MKVario/sweef/hardware/platine_v5/sweef_v5_bauteile_beschriftet.jpg

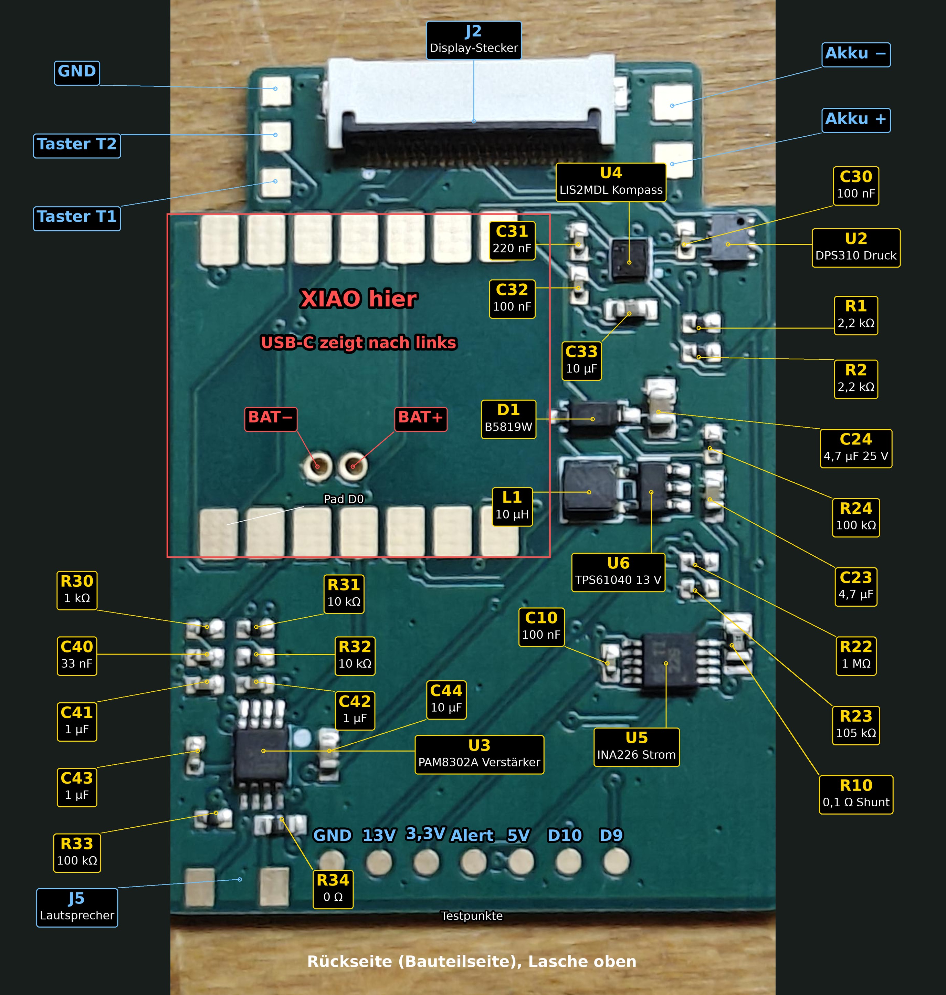
hardware/platine_v5/sweef_v5_bauteile_beschriftet.jpg
