MKVario/sweef/hardware/platine_v5/sweef_v5_vorderseite_beschriftet.jpg

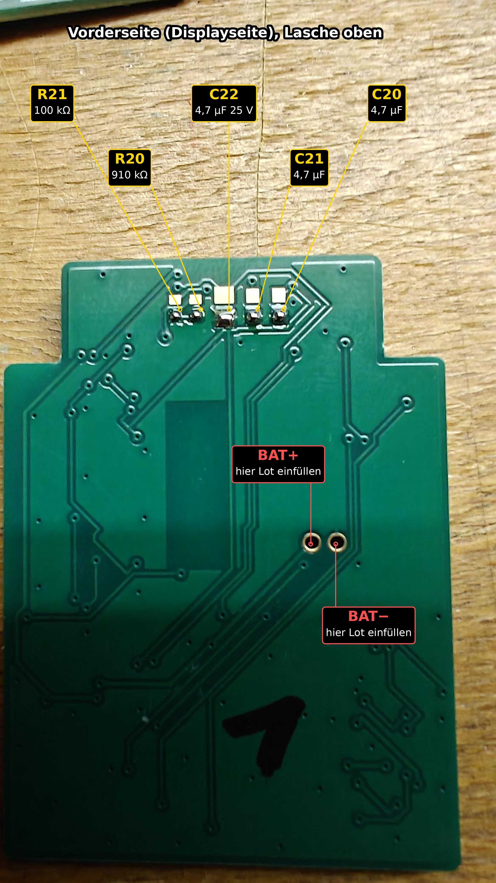
hardware/platine_v5/sweef_v5_vorderseite_beschriftet.jpg
