MKVario/sweef/docs/diagramme/sweef_akkutabelle_vergleich.png

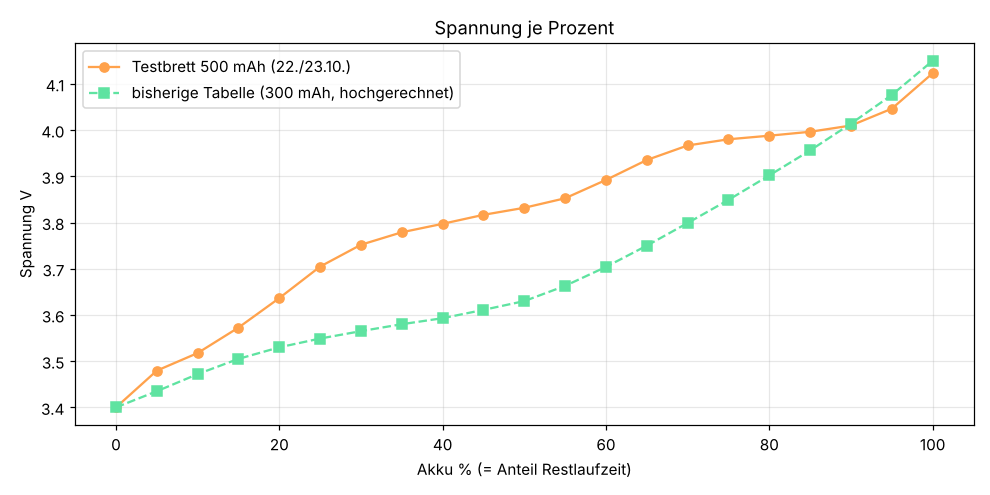
docs/diagramme/sweef_akkutabelle_vergleich.png
