MKVario/sweef/docs/diagramme/sweef_belastungstest.png

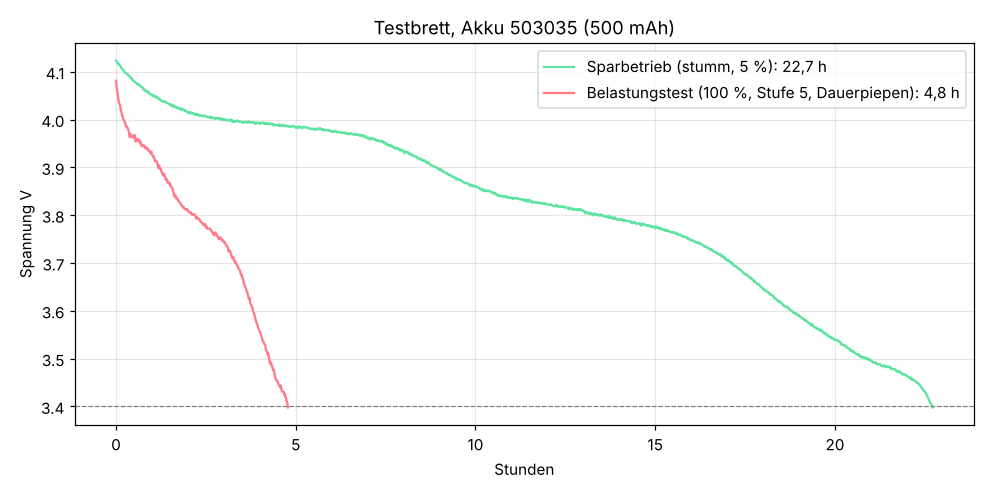
docs/diagramme/sweef_belastungstest.png
