MKVario/sweef/docs/diagramme/sweef_kompass_entwurf.png

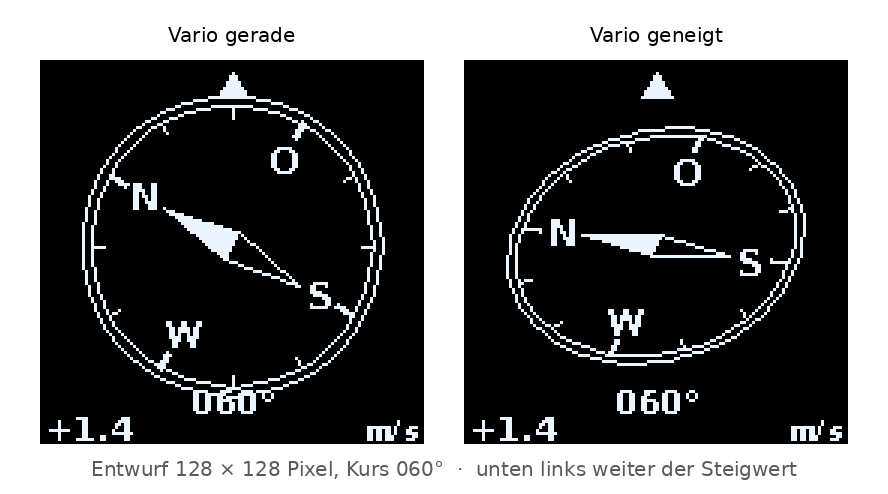
docs/diagramme/sweef_kompass_entwurf.png
