MKVario/sweef/docs/diagramme/sweef_ladekurve_2026-10-22.png

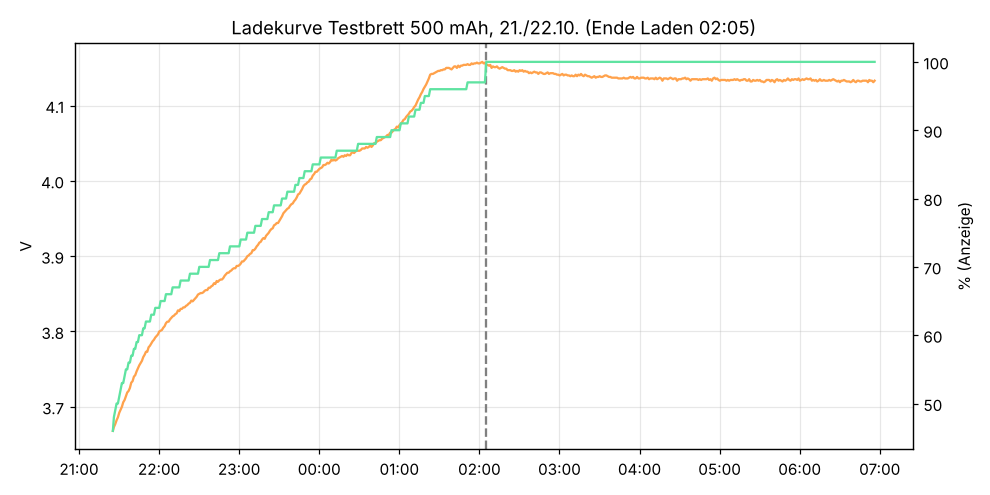
docs/diagramme/sweef_ladekurve_2026-10-22.png
