MKVario/sweef/docs/diagramme/sweef_platine_umriss_v1.png

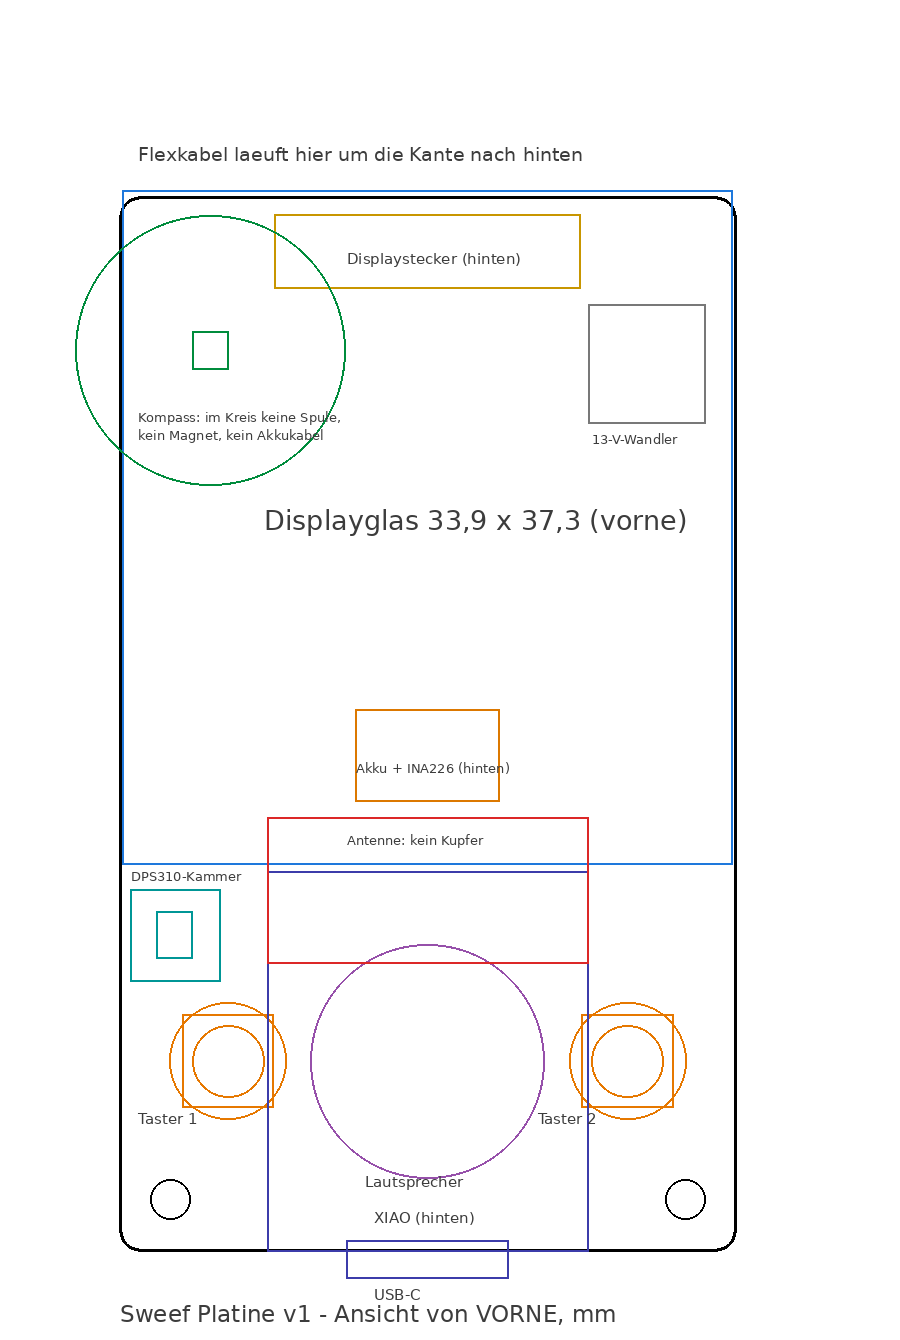
docs/diagramme/sweef_platine_umriss_v1.png
