MKVario/sweef/docs/diagramme/sweef_proportionen.png

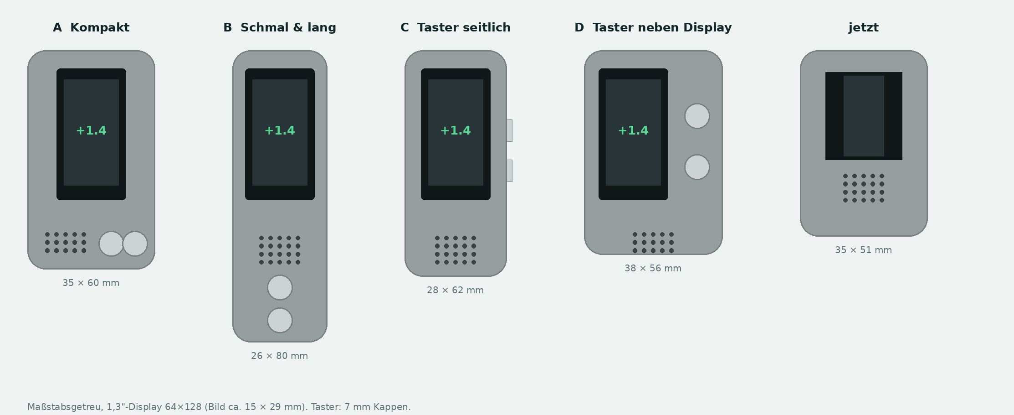
docs/diagramme/sweef_proportionen.png
