MKVario/sweef/docs/diagramme/sweef_rund_skizze.png

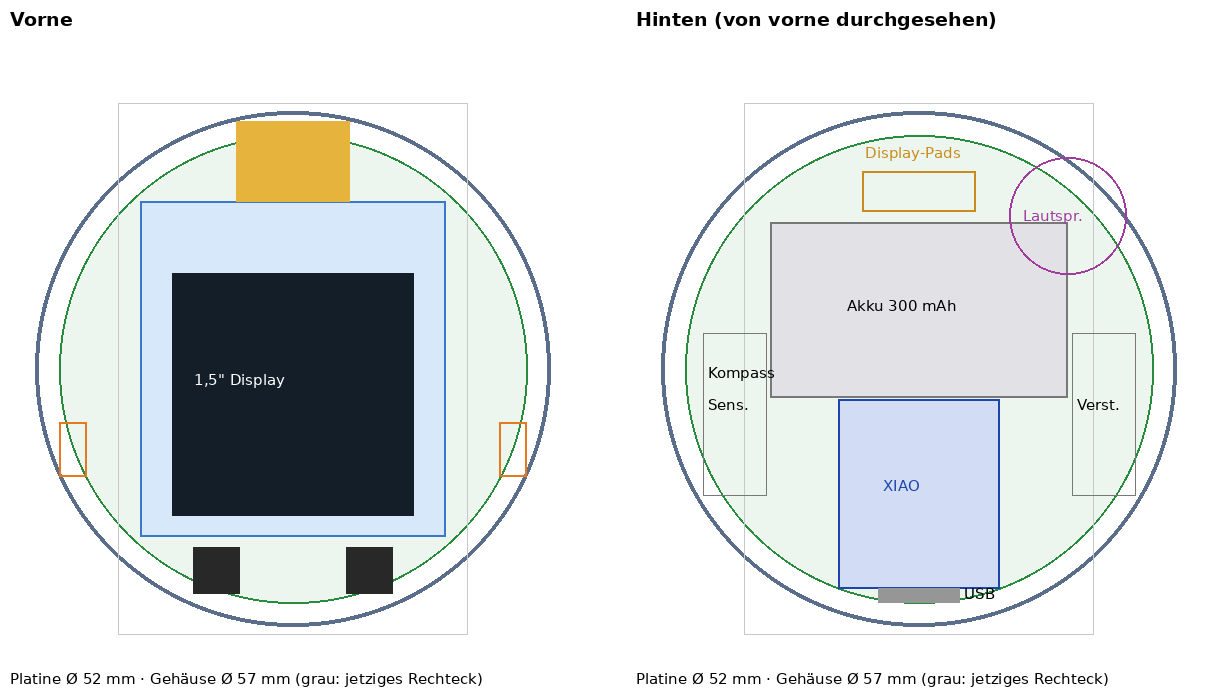
docs/diagramme/sweef_rund_skizze.png
