MKVario/sweef/docs/diagramme/sweef_skizze_platine.png

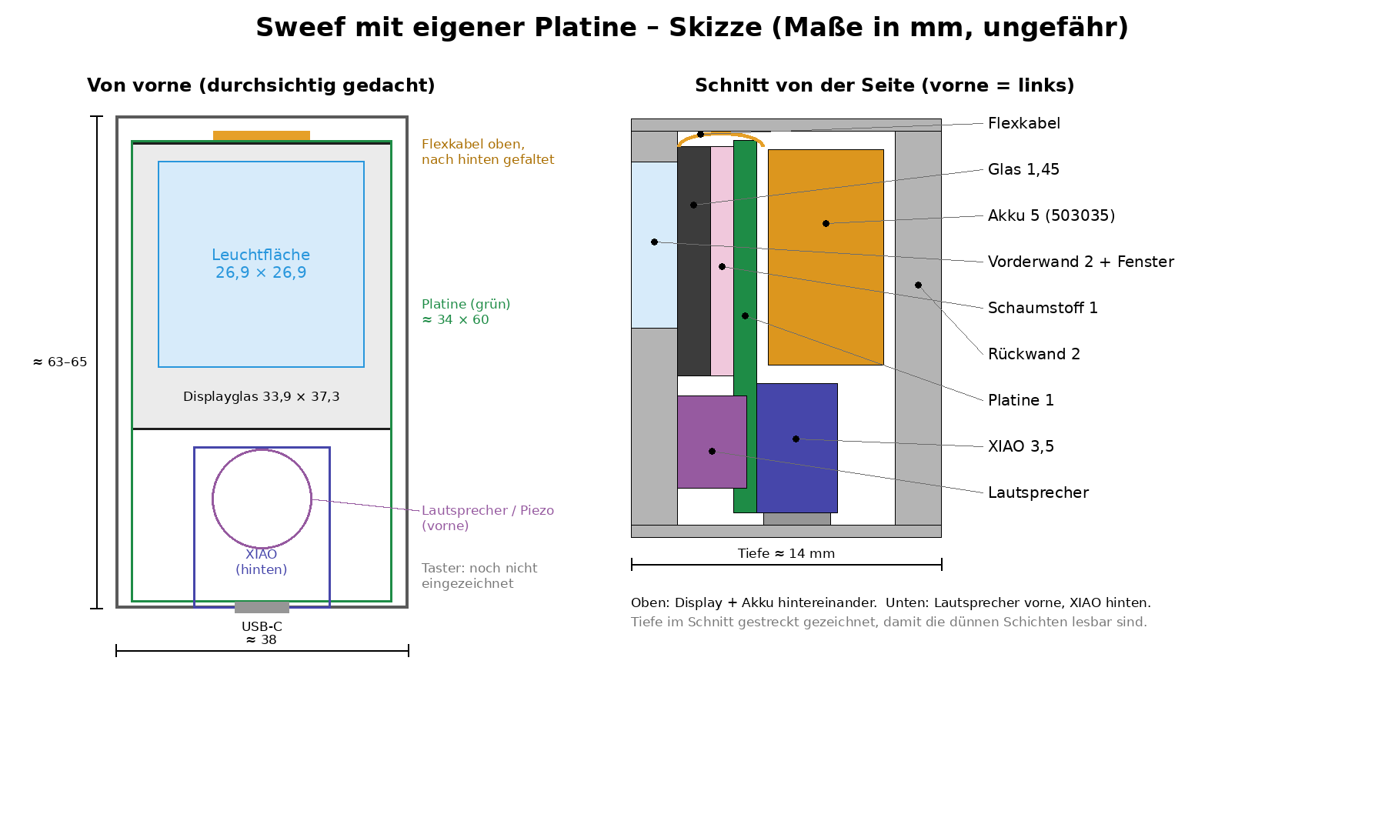
docs/diagramme/sweef_skizze_platine.png
