MKVario/sweef/docs/diagramme/sweef_taster_schnitt.png

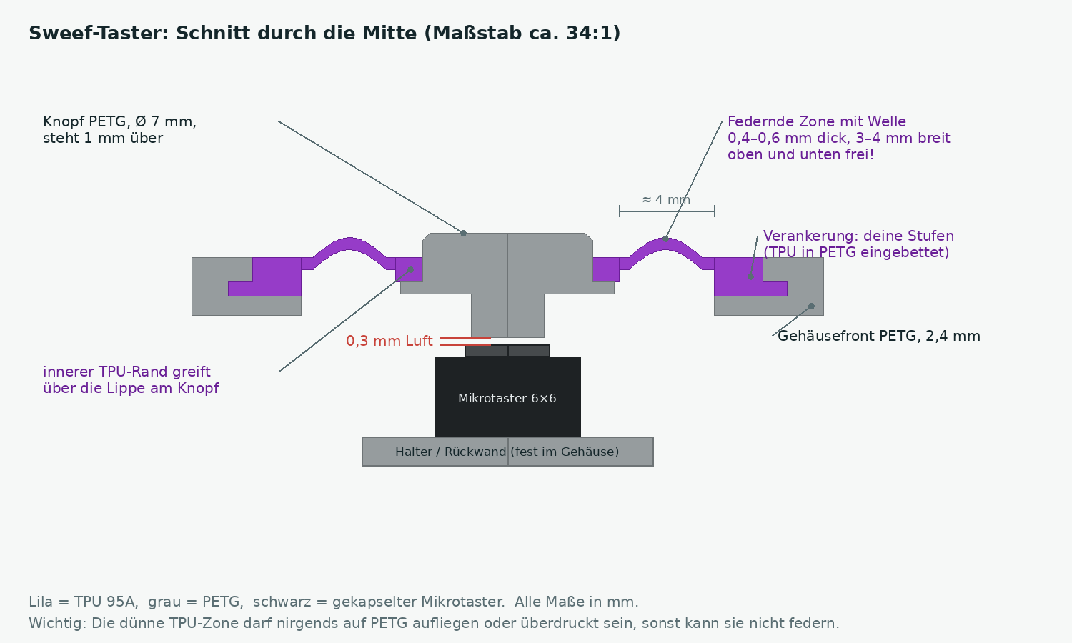
docs/diagramme/sweef_taster_schnitt.png
