MKVario/sweef/docs/diagramme/sweef_taster_stoessel.png

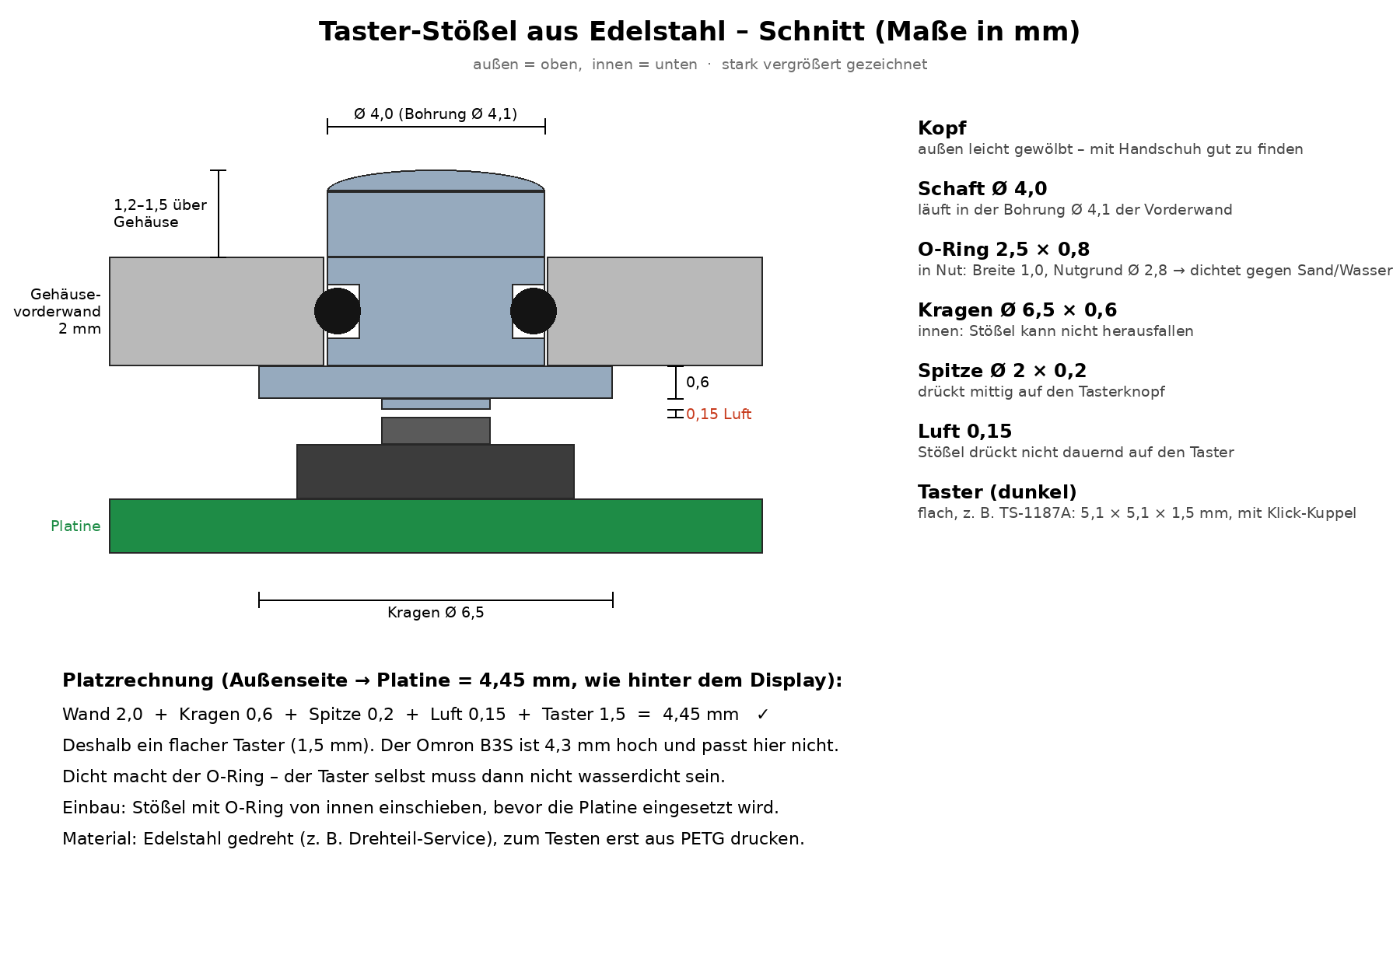
docs/diagramme/sweef_taster_stoessel.png
