MKVario/sweef/docs/diagramme/sweef_tropfen_skizze.png

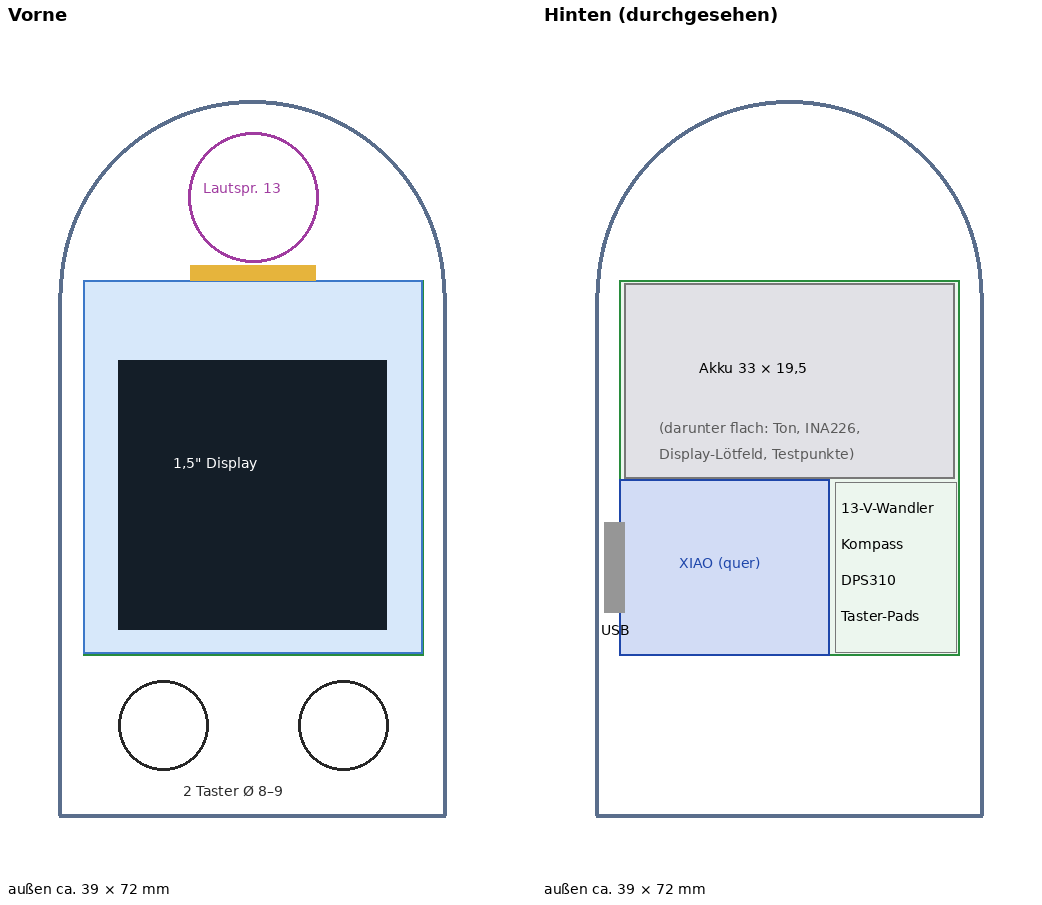
docs/diagramme/sweef_tropfen_skizze.png
