MKVario/sweef/docs/diagramme/sweef_verdrahtung.png

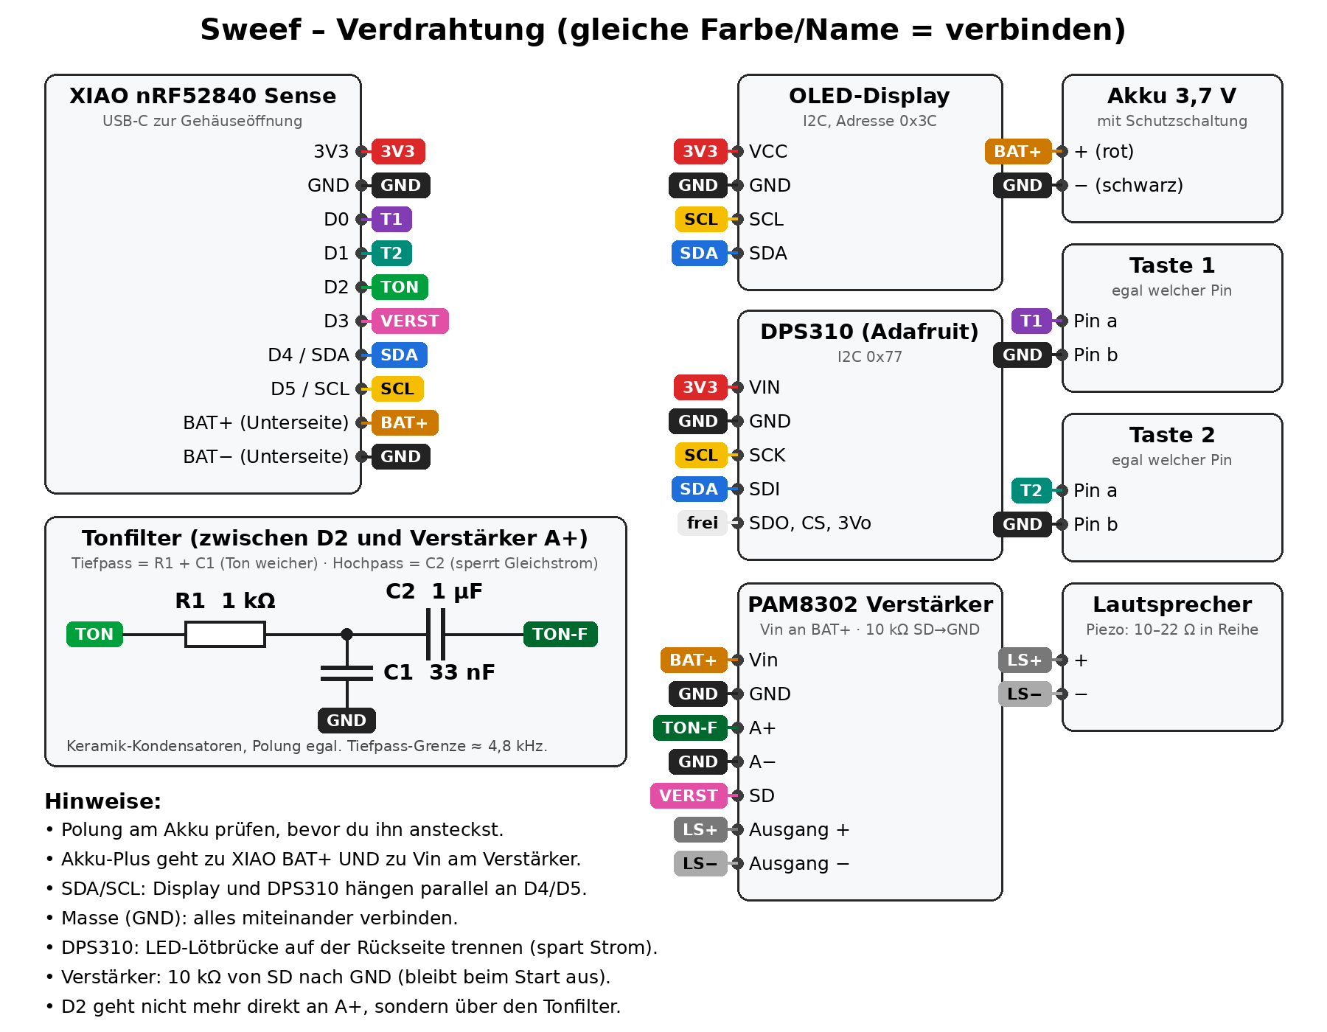
docs/diagramme/sweef_verdrahtung.png
