MKVario/sweef/hardware/gehaeuse/sweef_gehaeuse_v1_vorschau.png

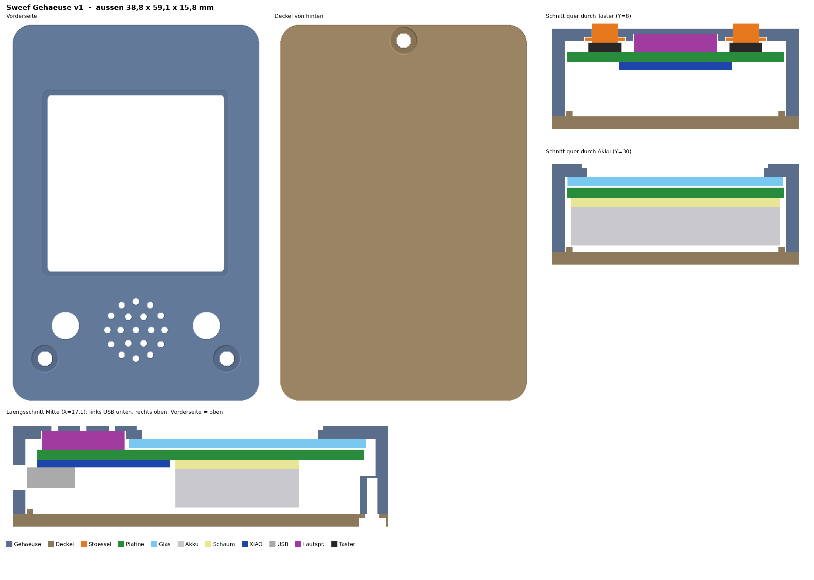
hardware/gehaeuse/sweef_gehaeuse_v1_vorschau.png
