MKVario/sweef/hardware/platine_v5/sweef_platine_umriss_v5.png

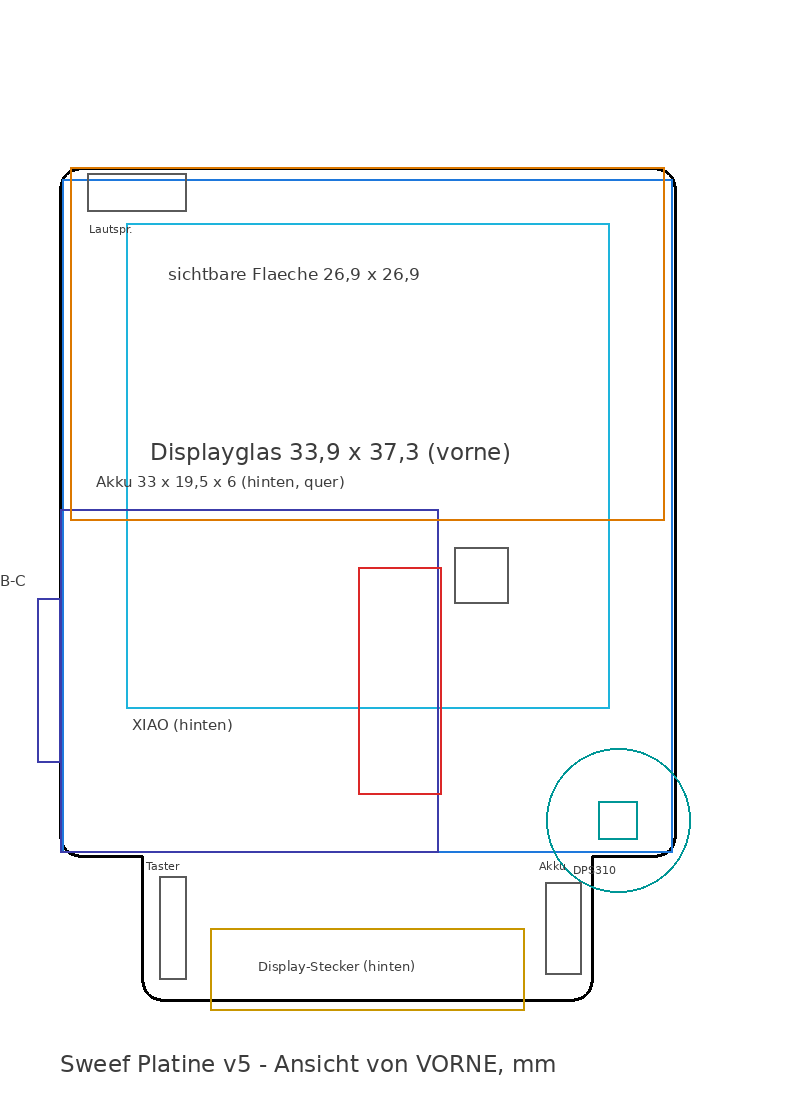
hardware/platine_v5/sweef_platine_umriss_v5.png
