MKVario/sweef/hardware/platine_v5/sweef_platine_v5_vorschau.png

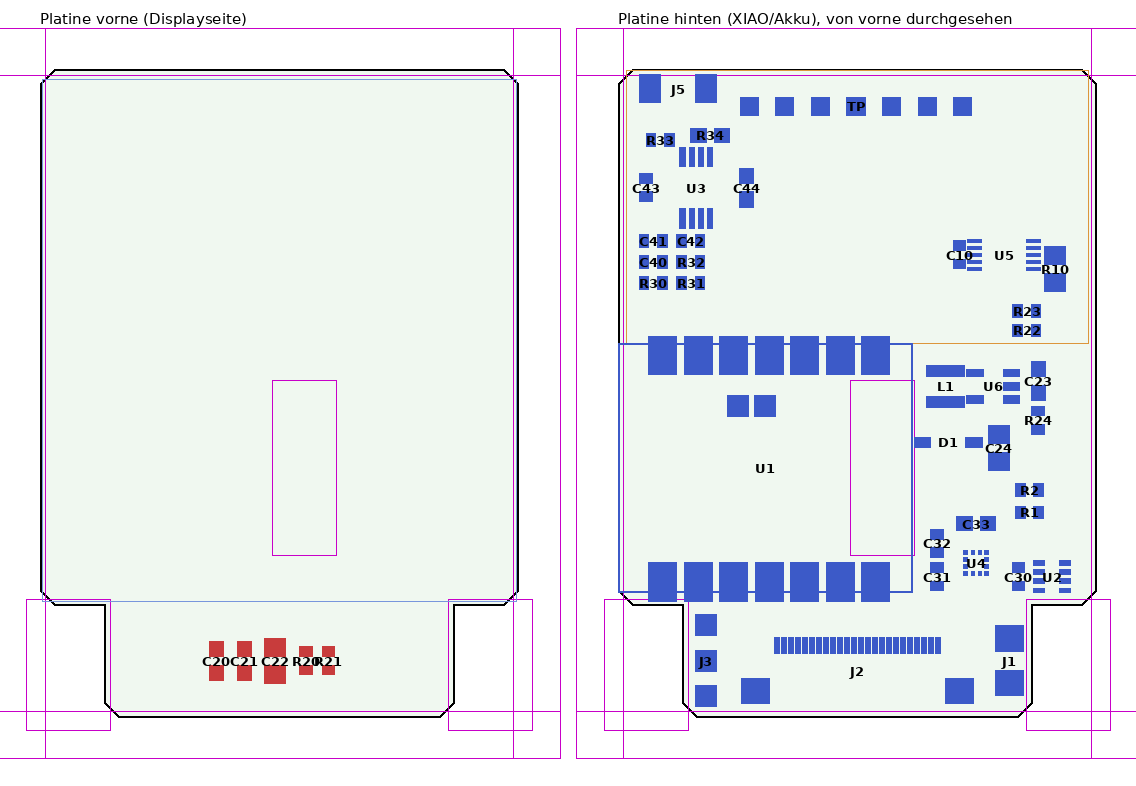
hardware/platine_v5/sweef_platine_v5_vorschau.png
