MKVario/sweef/hardware/Vario_Stueckliste.xlsx

Sheet: Stückliste
Stückliste Gleitschirm-Vario (Küstensoaring)
Gelbe Zellen selbst ausfüllen (Einzelpreis in €, Bestellnummer, Händler). Links sind Suchlinks, keine geprüften Produktseiten.
Pos. | Bauteil | Typ / Wert | Menge | Pflicht? | Bei Amazon suchen | Alternative Quelle | Einzelpreis (€) | Summe (€) | Händler / Bestellnr. | Anmerkung | Vorhanden daheim?
U1 | Controller | Seeed XIAO nRF52840 Sense (Standardversion, nicht Plus) | 1 | Ja | Amazon-Suche (https://www.amazon.de/s?k=Seeed+Studio+XIAO+nRF52840+Sense) | Berrybase (https://www.berrybase.de/search?sSearch=XIAO+nRF52840+Sense) |  |  |  | Sehr sparsamer Tiefschlaf, Bewegungssensor (LSM6DS3TR-C) ist eingebaut. Stiftleisten oder Randpads nutzbar.
U2 | Drucksensor | DPS310-Breakout (I²C) | 1 | Ja | Amazon-Suche (https://www.amazon.de/s?k=DPS310+Drucksensor+Modul+I2C) | Adafruit (https://www.adafruit.com/search?q=DPS310) |  |  |  | Vor Kauf prüfen: SDO und CSB herausgeführt bzw. auf I²C eingestellt, Pull-ups auf dem Board? | Gewählt: Adafruit-DPS310-Board (Berrybase) mit STEMMA-QT-Buchse. Kondensatoren, Regler und 10-kΩ-Pull-ups sind auf dem Board. Anschluss direkt an die Lötpads (VIN, GND, SCK, SDI), kein Kabel nötig.
DISP1 | OLED-Display | 0,91 Zoll, 128x32, SSD1306, I²C | 1 | Ja | Amazon-Suche (https://www.amazon.de/s?k=0%2C91+Zoll+OLED+Display+128x32+I2C+SSD1306) | Berrybase (https://www.berrybase.de/search?sSearch=OLED+0.91+SSD1306) |  |  |  | Adresse 0x3C. 4-Pin-Version mit VCC, GND, SCL, SDA. | Noch offen: 0,91 Zoll (128x32) oder 0,96 Zoll (128x64, quadratische Platine). Foto-Board hat 4,7-kΩ-Pull-ups, Kondensatoren, Regler.
U4 | Audio-Verstärker | PAM8302-Breakout (mono, Klasse D) | 1 | Ja | Amazon-Suche (https://www.amazon.de/s?k=PAM8302+Verstärker+Modul+2.5W+mono) | Adafruit (https://www.adafruit.com/search?q=PAM8302) |  |  |  | Pins prüfen: VIN, GND, A+, A-, SD (Shutdown), OUT+, OUT-. Versorgung aus dem Akku (ca. 2-5,5 V). | Gewähltes Board PAM8302A: Poti 'Vol', Schraubklemme für den Lautsprecher, Kondensatoren sind drauf.
LS1 | Lautsprecher | LSF-13SMD2 (Wunsch) oder abgedichtet LSF-S1318A-IPX7 (empfohlen wegen Sand), 8 Ω, ca. 0,7 W | 1 | Ja | Amazon-Suche (https://www.amazon.de/s?k=Lautsprecher+8+Ohm+0.7W+SMD+13mm) | Reichelt (https://www.reichelt.de/index.html?SEARCH=LSF-S1318A-IPX7) |  |  |  | Datenblatt prüfen: Impedanz, Leistung, Resonanz (ca. 850-1100 Hz). Nur an OUT+ und OUT-, nie an GND.
BT1 | Akku | LiPo 3,7 V, 500 mAh, mit Schutzschaltung | 1 | Ja | Amazon-Suche (https://www.amazon.de/s?k=LiPo+Akku+3.7V+500mAh+JST+PH+2.0+Schutzschaltung) | Berrybase (https://www.berrybase.de/search?sSearch=LiPo+500mAh) |  |  |  | Wegen des Lautsprechers 500 mAh. Typische Bauform 503035 (ca. 5 x 30 x 35 mm), Platz im Gehäuse prüfen. Polung des Steckers vor dem Anschließen prüfen (oft vertauscht).
J1 | Akkustecker | JST-PH 2-polig, Buchse für die Platine (THT) | 1 | Ja | Amazon-Suche (https://www.amazon.de/s?k=JST+PH+2.0+Buchse+2+polig+THT+Stiftleiste) | Reichelt (https://www.reichelt.de/index.html?SEARCH=JST+PH+2-polig+Stiftleiste) |  |  |  | Muss zum Stecker des Akkus passen (PH, 2,0 mm Raster).
SW1, SW2 | Taster | gekapselt, IP67, 6x6 mm, Silikonmembran | 2 | Ja | Amazon-Suche (https://www.amazon.de/s?k=Wasserdichter+Taster+IP67+6x6+Mini) | Reichelt (https://www.reichelt.de/index.html?SEARCH=Taster+IP67) |  |  |  | Ein/Aus bzw. Lautstärke und Höhen-Reset. Schalten gegen GND, keine Widerstände nötig. | ENTFÄLLT: ersetzt durch die Edelstahl-Einbautaster (nächste Zeile).
SW1, SW2 (Einbau) | Taster (Einbau) | Edelstahl, 8 mm Einbaudurchmesser, wasserdicht, Schließer, selbstrückstellend, mit O-Ring und Mutter | 2 | Ja | Amazon-Suche (https://www.amazon.de/s?k=Larcele+8mm+Mini+Metall+Drucktaster+wasserdicht+momentan+Edelstahl) | Reichelt (https://www.reichelt.de/index.html?SEARCH=Einbau+Drucktaster+8mm+Edelstahl+IP67) |  |  |  | Auf die linke Gehäuseseite, Mittenabstand mindestens 18-20 mm. Einfache Variante mit 2 Anschlüssen, ohne LED. In der Anzeige IP-Angabe, Gewindelänge und Kopfhöhe prüfen. Das Amazon-Set enthält 5 Stück (ca. 34,49 € laut Anzeige). Kabel an D0, D1 und GND.
C10, C11 | Kondensatoren | 100 nF, Keramik (bedrahtet oder 0805), am XIAO-Pin zwischen Signal und GND | 2 | Optional | Amazon-Suche (https://www.amazon.de/s?k=Kondensator+Keramik+100nF+bedrahtet+Sortiment) | Reichelt (https://www.reichelt.de/index.html?SEARCH=Keramikkondensator+100nF) |  |  |  | Optional: glättet Störungen auf den Tasterkabeln, schützt etwas vor statischer Entladung. | Ja
C1 | Kondensator | 10 µF, 0805 (Controller) | 1 | Ja | Amazon-Suche (https://www.amazon.de/s?k=0805+SMD+Kondensator+Sortiment+100nF+10uF+1uF) | Reichelt (https://www.reichelt.de/index.html?SEARCH=SMD+0805+10uF) |  |  |  | Amazon liefert meist Sortimente mit vielen Werten.
C2 | Kondensator | 100 nF, 0805 (Controller) | 1 | Ja | Amazon-Suche (https://www.amazon.de/s?k=0805+SMD+Kondensator+Sortiment+100nF+10uF+1uF) | Reichelt (https://www.reichelt.de/index.html?SEARCH=SMD+0805+100nF)
C3 | Kondensator | 10 µF, 0805 (Verstärker) | 1 | Ja | Amazon-Suche (https://www.amazon.de/s?k=0805+SMD+Kondensator+Sortiment+100nF+10uF+1uF) | Reichelt (https://www.reichelt.de/index.html?SEARCH=SMD+0805+10uF) |  |  |  | Direkt am Verstärker platzieren. | ENTFÄLLT beim gewählten PAM8302A-Board (Kondensatoren sind drauf).
C4 | Kondensator | 100 nF, 0805 (Verstärker) | 1 | Ja | Amazon-Suche (https://www.amazon.de/s?k=0805+SMD+Kondensator+Sortiment+100nF+10uF+1uF) | Reichelt (https://www.reichelt.de/index.html?SEARCH=SMD+0805+100nF) |  |  |  | Direkt am Verstärker platzieren. | ENTFÄLLT beim gewählten PAM8302A-Board (Kondensatoren sind drauf).
C5 | Kondensator | 1 µF, 0805 (Koppelkondensator am Verstärkereingang) | 1 | Ja | Amazon-Suche (https://www.amazon.de/s?k=0805+SMD+Kondensator+Sortiment+100nF+10uF+1uF) | Reichelt (https://www.reichelt.de/index.html?SEARCH=SMD+0805+1uF) |  |  |  | Entfällt, wenn das PAM8302-Board schon einen Eingangskondensator hat. | ENTFÄLLT beim gewählten PAM8302A-Board (Eingangskondensatoren sind drauf).
C6-C8 | Kondensatoren | 100 nF, 0805 (Sensoren) | 3 | Optional | Amazon-Suche (https://www.amazon.de/s?k=0805+SMD+Kondensator+Sortiment+100nF+10uF+1uF) | Reichelt (https://www.reichelt.de/index.html?SEARCH=SMD+0805+100nF) |  |  |  | Nur, wenn die Breakouts keine eigenen Kondensatoren haben. | ENTFÄLLT bei den gewählten Boards (DPS310-Board und OLED-Board haben eigene Kondensatoren).
C9 | Kondensator | Tiefpass für Tonsignal, Startwert ca. 22 nF, 0805 | 1 | Ja | Amazon-Suche (https://www.amazon.de/s?k=0805+SMD+Kondensator+Sortiment+100nF+10uF+1uF) | Reichelt (https://www.reichelt.de/index.html?SEARCH=SMD+0805+22nF) |  |  |  | Endgültiger Wert wird beim Test bestimmt.
R1, R2 | Widerstände | 4,7 kΩ, 0805 (I²C Pull-ups) | 2 | Optional | Amazon-Suche (https://www.amazon.de/s?k=0805+SMD+Widerstand+Sortiment+1%25+E12) | Reichelt (https://www.reichelt.de/index.html?SEARCH=SMD+0805+4%2C7k) |  |  |  | Entfallen, wenn die Breakouts Pull-ups haben. | ENTFALLEN bei den gewählten Boards (DPS310-Board und OLED-Board haben Pull-ups).
R3, R4 | Widerstände | Spannungsteiler am Verstärkereingang, Werte im Test (z. B. 1 kΩ bis 47 kΩ), 0805 | 2 | Ja | Amazon-Suche (https://www.amazon.de/s?k=0805+SMD+Widerstand+Sortiment+1%25+E12) | Reichelt (https://www.reichelt.de/index.html?SEARCH=SMD+0805+10k) |  |  |  | Begrenzt die Höchstlautstärke auf einen für den Lautsprecher sicheren Wert. | ENTFALLEN beim gewählten PAM8302A-Board (das Poti 'Vol' übernimmt die Begrenzung).
R5 | Widerstand | Tiefpass für Tonsignal, Startwert ca. 1 kΩ, 0805 | 1 | Ja | Amazon-Suche (https://www.amazon.de/s?k=0805+SMD+Widerstand+Sortiment+1%25+E12) | Reichelt (https://www.reichelt.de/index.html?SEARCH=SMD+0805+1k) |  |  |  | Endgültiger Wert wird beim Test bestimmt.
PCB | Platine | nach deinem Eagle-Layout | 1 | Ja | nicht bei Amazon | JLCPCB (https://jlcpcb.com/) |  |  |  | Bei Amazon nicht sinnvoll. Gerber-Dateien hochladen, z. B. bei JLCPCB oder PCBWay.
X1 | Stift-/Buchsenleisten | 2,54 mm, für die Module | 1 | Ja | Amazon-Suche (https://www.amazon.de/s?k=Stiftleiste+Buchsenleiste+2.54mm+Set) | Reichelt (https://www.reichelt.de/index.html?SEARCH=Stiftleiste+2%2C54) |  |  |  | Fest verlötet wird es flacher, Buchsen erlauben Modultausch.
X2 | Stiftleiste | 2-polig, 2,54 mm (Reset-Testpunkt) | 1 | Ja | Amazon-Suche (https://www.amazon.de/s?k=Stiftleiste+Buchsenleiste+2.54mm+Set) | Reichelt (https://www.reichelt.de/index.html?SEARCH=Stiftleiste+2%2C54) |  |  |  | Für den Notfall-Reset von Hand, wenn das Gerät hängt.
- | Schrauben, Abstandshalter | M2-Set, für Sensorboards und Gehäuse | 1 | Ja | Amazon-Suche (https://www.amazon.de/s?k=M2+Schrauben+Abstandshalter+Set+Nylon) | Reichelt (https://www.reichelt.de/index.html?SEARCH=Abstandsbolzen+M2) |  |  |  | Sensorboards starr befestigen.
- | Schutzlack | Conformal Coating, Dose/Spray | 1 | Ja | Amazon-Suche (https://www.amazon.de/s?k=Schutzlack+Platine+Conformal+Coating+Spray) | Reichelt (https://www.reichelt.de/index.html?SEARCH=Schutzlack+Platine) |  |  |  | Erst nach dem Test auftragen, Anschlüsse und Taster vorher abkleben.
- | Staubschutz USB-C | Silikonkappe | 1 | Ja | Amazon-Suche (https://www.amazon.de/s?k=Silikon+Staubschutz+USB-C+Stopfen) | - |  |  |  | Hält Sand aus dem Anschluss.
- | Gitter vor dem Lautsprecher | Edelstahlgewebe, fein | 1 | Ja | Amazon-Suche (https://www.amazon.de/s?k=Edelstahl+Gewebe+Mesh+fein+Filter) | - |  |  |  | Schutz vor Sand.
- | Membran vor dem Drucksensor | PTFE, wasserabweisend, belüftend | 1 | Ja | Amazon-Suche (https://www.amazon.de/s?k=PTFE+Membran+Belüftung+wasserdicht+Aufkleber+Vent) | - |  |  |  | Muss luftdurchlässig sein.
- | Schaumstoff | klein, dünn | 1 | Ja | Amazon-Suche (https://www.amazon.de/s?k=Schaumstoff+Platte+3mm+selbstklebend) | - |  |  |  | Winddämpfung am Drucksensor, Entkopplung des Lautsprechers.
- | Dichtung | Silikon-Dichtschnur oder Silikonband | 1 | Ja | Amazon-Suche (https://www.amazon.de/s?k=Silikon+Dichtschnur+2mm+rund) | - |  |  |  | Umlaufend am Gehäuse.
- | Gehäuse-Material | PETG-Filament, weiß oder hellgrau | 1 | Ja | Amazon-Suche (https://www.amazon.de/s?k=PETG+Filament+1.75mm+weiß) | - |  |  |  | Nur, wenn du selbst druckst. Hell wegen Sonne.
- | Befestigung am Tragegurt | Klettband oder Clip | 1 | Ja | Amazon-Suche (https://www.amazon.de/s?k=Klettband+Set+selbstklebend+breit) | - |  |  |  | Je nach Gurtbreite.
- | Litze | dünn, z. B. 0,14 mm² | 1 | Ja | Amazon-Suche (https://www.amazon.de/s?k=Silikonlitze+26AWG+Set) | -
- | Schrumpfschlauch | Sortiment | 1 | Ja | Amazon-Suche (https://www.amazon.de/s?k=Schrumpfschlauch+Set) | -
- | USB-C-Datenkabel | kurz, mit Datenleitungen | 1 | Ja | Amazon-Suche (https://www.amazon.de/s?k=USB-C+Datenkabel+kurz) | - |  |  |  | Kein reines Ladekabel, sonst kein Programmieren möglich.
T1 | Kondensatoren (bedrahtet) | 100 nF, Keramik, Raster 2,5 oder 5 mm (statt C2, C4, optional C6/C7) | 4 | Alternativ | Amazon-Suche (https://www.amazon.de/s?k=Kondensator+Keramik+100nF+bedrahtet+Sortiment) | Reichelt (https://www.reichelt.de/index.html?SEARCH=Keramikkondensator+100nF) |  |  |  | Für die gedruckte Trägerplatte: Ersatz für die 0805-SMD-Teile. Direkt an die Versorgungspins der Module löten. | Mit den gewählten Boards nur noch für C2 nötig (C4, C6, C7 entfallen). | Ja
T2 | Kondensatoren (bedrahtet) | 10 µF Elko, mind. 16 V (statt C1, C3) | 2 | Alternativ | Amazon-Suche (https://www.amazon.de/s?k=Elko+10uF+16V+bedrahtet+Sortiment) | Reichelt (https://www.reichelt.de/index.html?SEARCH=Elko+10uF+16V+radial) |  |  |  | Polung beachten (Minus-Streifen am Gehäuse). | Mit den gewählten Boards nur noch für C1 nötig (C3 entfällt). | Ja
T3 | Kondensator (bedrahtet) | 1 µF, Folie oder Keramik (statt C5) | 1 | Alternativ | Amazon-Suche (https://www.amazon.de/s?k=Kondensator+1uF+bedrahtet+Folie+Keramik) | Reichelt (https://www.reichelt.de/index.html?SEARCH=Kondensator+1uF+RM5) |  |  |  | Entfällt, wenn das PAM8302-Board einen Eingangskondensator hat. | ENTFÄLLT beim gewählten PAM8302A-Board. | Ja
T4 | Kondensator (bedrahtet) | ca. 22 nF, Folie oder Keramik (statt C9) | 1 | Alternativ | Amazon-Suche (https://www.amazon.de/s?k=Kondensator+22nF+bedrahtet+Folie) | Reichelt (https://www.reichelt.de/index.html?SEARCH=Kondensator+22nF+RM5) |  |  |  | Endgültiger Wert wird beim Test bestimmt. | Ja
T5 | Widerstände (bedrahtet) | 1/4 W, Sortiment E12 (statt R1-R5) | 5 | Alternativ | Amazon-Suche (https://www.amazon.de/s?k=Widerstand+Sortiment+1%2F4W+E12+bedrahtet) | Reichelt (https://www.reichelt.de/index.html?SEARCH=Widerstand+1%2F4W+Sortiment) |  |  |  | R5 Startwert 1 kΩ, R3/R4 im Test, R1/R2 (4,7 kΩ) nur falls die Boards keine Pull-ups haben. | Mit den gewählten Boards nur noch für R5 nötig (R1-R4 entfallen). | Ja
T6 | Lochrasterplatine | Stück ca. 20 x 15 mm, Raster 2,54 mm | 1 | Alternativ | Amazon-Suche (https://www.amazon.de/s?k=Lochrasterplatine+2.54mm+Set+klein) | Reichelt (https://www.reichelt.de/index.html?SEARCH=Lochrasterplatine+2%2C54) |  |  |  | Für die Audio-Filterkette (R5, C9, R3, R4, C5). Wird in die Trägerplatte eingesetzt.
T7 | Gewindeeinsätze und Schrauben | M2 Heat-Set-Einsätze, M2-Schrauben, Set | 1 | Alternativ | Amazon-Suche (https://www.amazon.de/s?k=M2+Gewindeeinsätze+Heat+Set+3D+Druck+Set+Schrauben) | Reichelt (https://www.reichelt.de/index.html?SEARCH=Gewindeeinsatz+M2) |  |  |  | Für die gedruckte Trägerplatte. Direkt in den Kunststoff gedrehte Gewinde lockern sich bei Vibration.
T8 | Kabel STEMMA QT / Qwiic | JST-SH 1,0 mm, 4-polig, ein Ende offen (Adern), ca. 10-20 cm | 1 | Alternativ | Amazon-Suche (https://www.amazon.de/s?k=STEMMA+QT+Qwiic+Kabel+JST+SH+4+Pin+offenes+Ende) | Adafruit (https://www.adafruit.com/search?q=STEMMA+QT+cable) |  |  |  | Für den DPS310 (Adafruit-Board): rot = VIN, schwarz = GND, gelb = SCL, blau = SDA. Prüfen, ob es schon im Lieferumfang ist. Stecker mit Heißkleber sichern. | ENTFÄLLT: Der DPS310 wird direkt an die Lötpads gelötet, das STEMMA-QT-Kabel wird nicht gebraucht.
 |  |  |  |  |  | Gesamt (nur Pflichtteile) |  | 0.00 €
 |  |  |  |  |  | Gesamt (inkl. optional) |  | 0.00 €
 |  |  |  |  |  | Alternative bedrahtete Teile (rot) |  | 0.00 €

Sheet: Hinweise
Hinweise zur Stückliste
Preise: Ich habe bewusst keine Preise eingetragen, weil ich sie nicht live prüfen kann. Trage sie in die gelben Zellen ein (Beispiel: 7,90).
Links: Alle Links sind Suchanfragen bei Amazon.de bzw. dem jeweiligen Shop, keine geprüften Produktseiten. Lieferbarkeit und Preis prüfst du dort selbst.
Sets: Amazon verkauft Kleinteile (Kondensatoren, Widerstände, Schrauben, Litze) meist als Sortiment. Die Spalte Menge zeigt den Bedarf, nicht die Packungsgröße.
Controller: XIAO nRF52840 Sense in der Standardversion. Der Bewegungssensor ist auf dem Board eingebaut, ein extra Sensorboard ist nicht nötig.
Ton: Lautsprecher plus PAM8302 ersetzen den Piezo-Summer. Die Werte von C9, R3, R4 und R5 werden beim Test bestimmt. Die Lautstärke wird in Stufen per Software geregelt.
Bedienung: Zwei Taster (SW1, SW2) ersetzen den Schalter. Einschalten und Ausschalten mit Bestätigungsabfrage, Höhen-Reset und Geräte-Reset per Tastenkombination. Dafür braucht es Tiefschlaf im Controller.
Rot markiert: Ergänzungen für die gedruckte Trägerplatte. Bedrahtete Teile ersetzen die 0805-SMD-Teile (Pos. C1-C9, R1-R5) und werden nicht zusätzlich zu ihnen gekauft. Sie zählen nicht in die ersten beiden Summen.
Zeilen mit ENTFÄLLT bzw. ENTFALLEN in der Anmerkung brauchst du bei den gewählten Boards nicht zu kaufen. Lass dort den Preis leer.
Spalte Vorhanden daheim?: Trage Ja ein bei Teilen, die du schon hast (bedrahtete Bauteile sind vorbelegt). Diese Zeilen zählen nicht in die Summen und müssen nicht bestellt werden.
Optional (grau): C6-C8 und R1/R2 werden nur gebraucht, wenn die Breakouts diese Bauteile nicht selbst tragen.
Sensoren und Verstärker: Vor dem Kauf die Pinbeschriftung auf den Produktfotos prüfen (SDO/CSB, SD, OUT+/OUT-, vorhandene Pull-ups und Koppelkondensatoren).
Leiterplatte: Die Platine bestellst du nicht bei Amazon, sondern bei einem Platinenfertiger (z. B. JLCPCB oder PCBWay) mit deinen Gerber-Dateien.
