MKVario/sweef/hardware/platine_v5/jlc/sweef_v5_BOM.csv

Comment | Designator | Footprint | LCSC Part #
100nF | C10,C30,C32 | 0402 | C1525
4.7uF | C23 | 0603 | C19666
4.7uF 25V | C24 | 0805 | C1779
220nF | C31 | 0402 | C16772
10uF | C33,C44 | 0603 | C19702
33nF | C40 | 0402 | C60425
1uF | C41,C42,C43 | 0402 | C52923
B5819W | D1 | SOD-123 | C8598
Display-Stecker | J2 | FPC-24P-0.5 | C2856831
10uH | L1 | 3x3 | C45403
2.2k | R1,R2 | 0402 | C25879
0.1R 1% | R10 | 0805
1M | R22 | 0402 | C26083
105k | R23 | 0402 | C25742
100k | R24,R33 | 0402 | C25741
1k | R30 | 0402 | C11702
10k | R31,R32 | 0402 | C25744
0R | R34 | 0603 | C21189
DPS310 | U2 | LGA-8 | C130156
PAM8302A | U3 | MSOP-8 | C113367
LIS2MDL | U4 | LGA-12 | C919695
INA226 | U5 | MSOP-10 | C49851
TPS61040 | U6 | SOT-23-5 | C7722
