MKVario/sweef/hardware/platine_v5/step/sweef_platine_v5_bestueckt.step

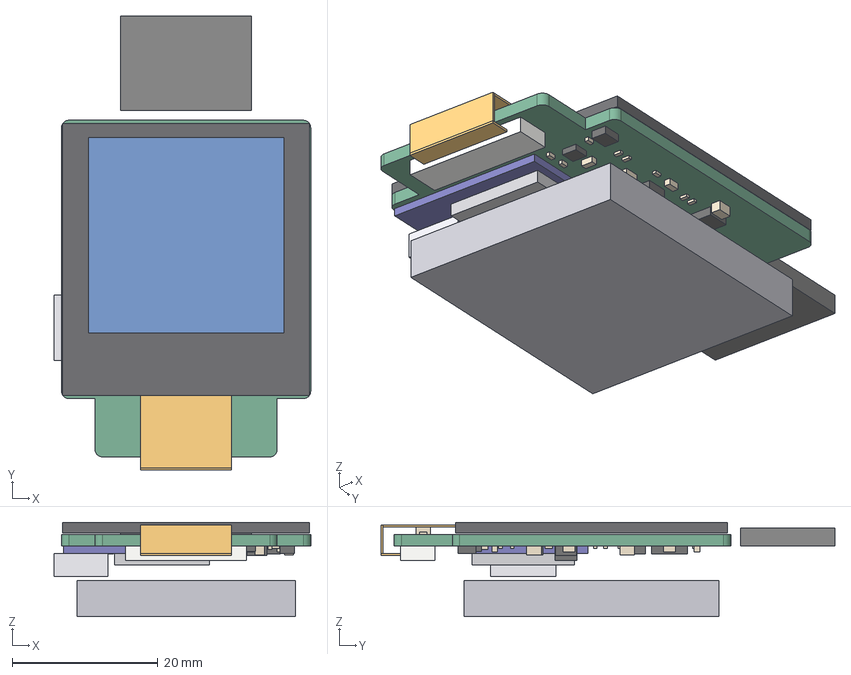
[picture p18: CAD file, 2026-11-12]
hardware/platine_v5/step/sweef_platine_v5_bestueckt.step
35.2 x 62.3 x 13.0 mm
Platine_1,6mm
R10_0805-NO
U5_MSOP10
C10_C0402
R1_R0402
R2_R0402
J2_FPC-24_XUNPU_FPC-05FB-24PH20
C20_0603-NO
C21_0603-NO
C22_0805-NO
R20_R0402
R21_R0402
U6_SOT23-5
L1_INDUCTOR_3X3
D1_SOD-123
C23_0603-NO
C24_0805-NO
R22_R0402
R23_R0402
R24_R0402
U2_BMX280_COMBO
C30_C0402
U4_LGA12_2X2MM
C31_C0402
C32_C0402
C33_0603-NO
R30_R0402
C40_C0402
C41_C0402
R31_R0402
R32_R0402
C42_C0402
U3_MSOP8_0.65MM
C43_C0402
C44_0603-NO
R33_R0402
R34_0603-NO
XIAO_Platine
XIAO_Bauteile
XIAO_USB-C
Displayglas_GME128128-02
Display_aktive_Flaeche
FPC_vorne
FPC_Schlaufe
FPC_hinten
Akku_503035_Lage_frei
Lautsprecher_LSF-S1318A_Lage_frei
