MKVario/sweef/hardware/platine_v5/sweef_platine_umriss_v5.dxf

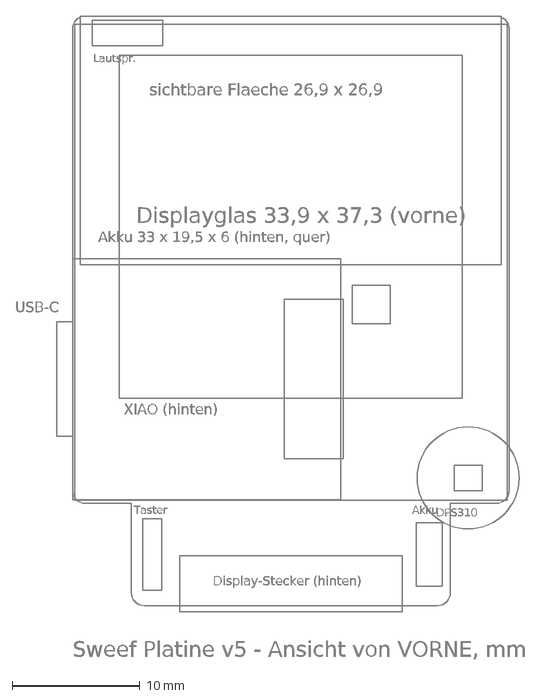
[picture p19: CAD file, 2026-11-12]
hardware/platine_v5/sweef_platine_umriss_v5.dxf
Sweef Platine v5 - Ansicht von VORNE, mm
Displayglas 33,9 x 37,3 (vorne)
sichtbare Flaeche 26,9 x 26,9
XIAO (hinten)
USB-C
Akku 33 x 19,5 x 6 (hinten, quer)
DPS310
Display-Stecker (hinten)
Lautspr.
Akku
Taster
