MKVario/sweef/docs/messdaten/2026-10-19_testbrett_entladen.csv

Datum | Uhrzeit | Minuten | Akku_% | Spannung_V | Laedt | USB
19.10.2026 | 20:43:57 | 0 | 100 | 4,159 | 0 | 0
19.10.2026 | 20:43:59 | 0 | 100 | 4,157 | 0 | 0
19.10.2026 | 20:44:58 | 1 | 100 | 4,150 | 0 | 0
19.10.2026 | 20:45:58 | 2 | 100 | 4,148 | 0 | 0
19.10.2026 | 20:46:58 | 3 | 100 | 4,144 | 0 | 0
19.10.2026 | 20:47:58 | 4 | 100 | 4,143 | 0 | 0
19.10.2026 | 20:48:58 | 5 | 100 | 4,142 | 0 | 0
19.10.2026 | 20:49:58 | 6 | 100 | 4,143 | 0 | 0
19.10.2026 | 20:50:58 | 7 | 100 | 4,139 | 0 | 0
19.10.2026 | 20:51:58 | 8 | 100 | 4,139 | 0 | 0
19.10.2026 | 20:52:58 | 9 | 100 | 4,136 | 0 | 0
19.10.2026 | 20:53:58 | 10 | 100 | 4,135 | 0 | 0
19.10.2026 | 20:54:58 | 11 | 100 | 4,134 | 0 | 0
19.10.2026 | 20:55:58 | 12 | 99 | 4,133 | 0 | 0
19.10.2026 | 20:56:58 | 13 | 99 | 4,132 | 0 | 0
19.10.2026 | 20:57:58 | 14 | 99 | 4,130 | 0 | 0
19.10.2026 | 20:58:58 | 15 | 99 | 4,129 | 0 | 0
19.10.2026 | 20:59:58 | 16 | 99 | 4,129 | 0 | 0
19.10.2026 | 21:00:58 | 17 | 99 | 4,128 | 0 | 0
19.10.2026 | 21:01:58 | 18 | 97 | 4,125 | 0 | 0
19.10.2026 | 21:02:58 | 19 | 97 | 4,124 | 0 | 0
19.10.2026 | 21:03:58 | 20 | 97 | 4,125 | 0 | 0
19.10.2026 | 21:04:58 | 21 | 97 | 4,124 | 0 | 0
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
