MKVario/sweef/docs/messdaten/2026-10-21_testbrett_2.csv

Datum | Uhrzeit | Minuten | Akku_% | Spannung_V | Laedt | USB
21.10.2026 | 21:25:22 | 0 | 46 | 3,668 | 1 | 1
21.10.2026 | 21:26:08 | 1 | 48 | 3,673 | 1 | 1
21.10.2026 | 21:27:08 | 2 | 49 | 3,677 | 1 | 1
21.10.2026 | 21:28:08 | 3 | 50 | 3,682 | 1 | 1
21.10.2026 | 21:29:08 | 4 | 50 | 3,686 | 1 | 1
21.10.2026 | 21:30:08 | 5 | 51 | 3,692 | 1 | 1
21.10.2026 | 21:31:08 | 6 | 52 | 3,696 | 1 | 1
21.10.2026 | 21:32:08 | 7 | 53 | 3,700 | 1 | 1
21.10.2026 | 21:33:08 | 8 | 53 | 3,706 | 1 | 1
21.10.2026 | 21:34:08 | 9 | 54 | 3,709 | 1 | 1
21.10.2026 | 21:35:08 | 10 | 55 | 3,714 | 1 | 1
21.10.2026 | 21:36:08 | 11 | 55 | 3,719 | 1 | 1
21.10.2026 | 21:37:08 | 12 | 56 | 3,721 | 1 | 1
21.10.2026 | 21:38:08 | 13 | 56 | 3,725 | 1 | 1
21.10.2026 | 21:39:08 | 14 | 57 | 3,732 | 1 | 1
21.10.2026 | 21:40:08 | 15 | 57 | 3,734 | 1 | 1
21.10.2026 | 21:41:08 | 16 | 58 | 3,740 | 1 | 1
21.10.2026 | 21:42:08 | 17 | 58 | 3,742 | 1 | 1
21.10.2026 | 21:43:08 | 18 | 59 | 3,747 | 1 | 1
21.10.2026 | 21:44:08 | 19 | 59 | 3,751 | 1 | 1
21.10.2026 | 21:45:08 | 20 | 60 | 3,755 | 1 | 1
21.10.2026 | 21:46:08 | 21 | 60 | 3,758 | 1 | 1
21.10.2026 | 21:47:08 | 22 | 60 | 3,761 | 1 | 1
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
