MKVario/sweef/hardware/gehaeuse/Vario_Gehaeuse_Zeichnung.pdf

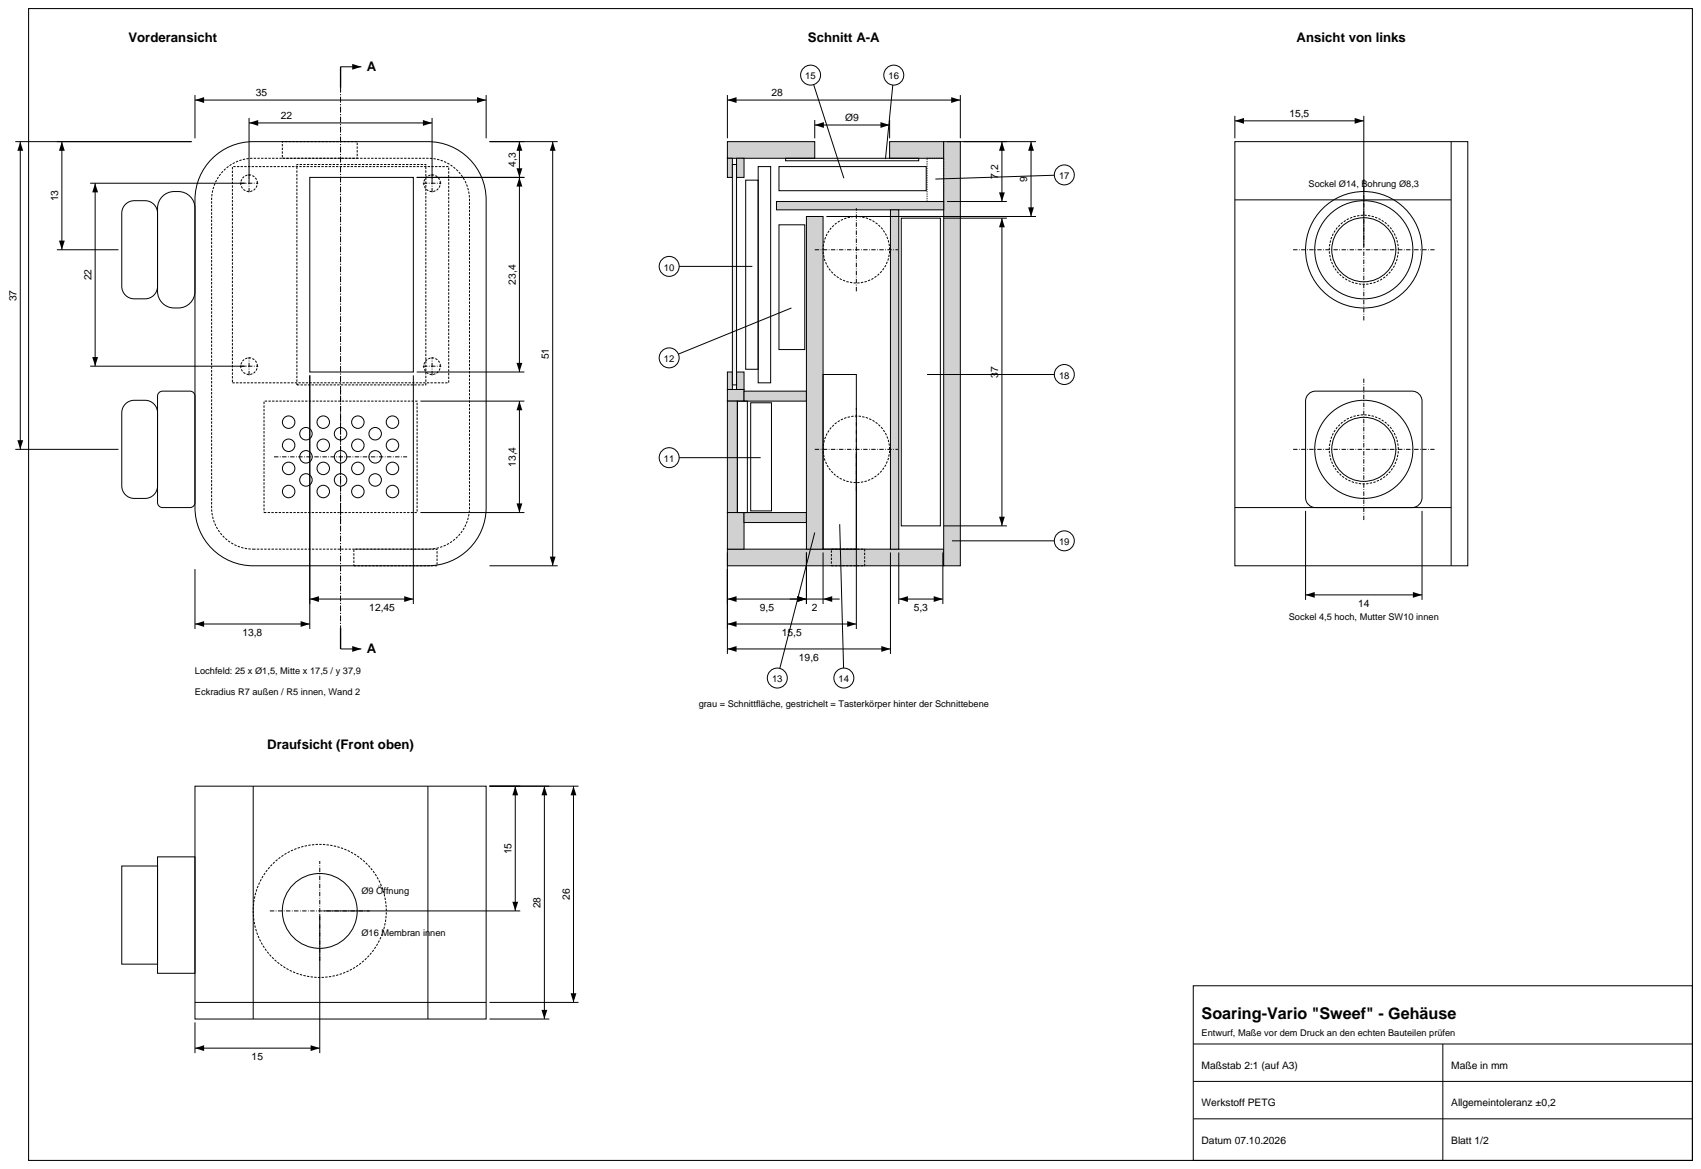
[picture p22: page 1]
Vorderansicht; Schnitt A-A; Sockel Ø14, Bohrung Ø8,3; Ø9 Öffnung; Ø16 Membran innen; Maßstab 2:1 (auf A3); Maße in mm; Werkstoff PETG; Allgemeintoleranz ±0,2; Datum 07.10.2026; Blatt 1/2

Ansicht von links

Sockel 4,5 hoch, Mutter SW10 innen

Lochfeld: 25 x Ø1,5, Mitte x 17,5 / y 37,9
Eckradius R7 außen / R5 innen, Wand 2

grau = Schnittfläche, gestrichelt = Tasterkörper hinter der Schnittebene

Draufsicht (Front oben)

Soaring-Vario "Sweef" - Gehäuse

Entwurf, Maße vor dem Druck an den echten Bauteilen prüfen

Soaring-Vario "Sweef" - Gehäuse, Blatt 2/2

Maßtabelle (mm, Nullpunkt: vordere obere linke Außenecke, x nach rechts, y nach unten, z nach hinten)

Nr | Element | x | y | z | Hinweis
1 | Membranöffnung oben | Mitte 15, Ø9 | 0-2 | Mitte 15 | Membran innen, Ø16
2 | Tasche Schutzscheibe | 12,25-27,75 | 2,75-29,25 | 0,6-1,1 | Lippe außen 0,6
3 | Fenster | 13,8-26,25 | 4,3-27,7 | 0-2 | Pins des Displays rechts
4 | Display-Stifte | 6,5 / 28,5 | 5 / 27 | 2-3,7 | Sockel Ø5, Stift Ø1,85x2,8
5 | Lochfeld | Mitte 17,5 | Mitte 37,9 | 0-1,2 | 25 x Ø1,5
6 | Lautsprecherkammer innen | 8,3-26,7 | 31,2-44,6 | 2-9,5 | Wände 1,2
7 | USB-C-Öffnung | 19,1-29,1 | 49-51 | 12,5-16,5 | nach XIAO messen
8 | Taster oben / unten | links | Mitte 13 / 37 | Mitte 15,5 | Sockel Ø14 x 4,5
9 | Innenkontur | 2-33 | 2-49 | 2-26 | R5 innen
10 | Display Glas / Platine | 4,5-30,5 | 3-29 | 2,2-5,8 | Glas 0,2 hinter Wand
11 | Lautsprecher | in Kammer | 31,4-44,4 | 2,8-5,3 | Klemmrahmen 1,4-2,4
12 | Verstärker (quer) | 5,7-29,3 | 10-25 | 6,2-9,3 | vor Halteplatte
13 | Halteplatte | 2-33 | 9-49 | 9,5-11,5 | = Kammerdeckel
14 | XIAO | 15,2-33 | 28-49 | 11,5-15,5 | Tasche, USB unten
15 | DPS310 im Fach | 4,75-30,25 | 3,0-5,9 | 6,2-23,9 | Fach y 2-7,2
16 | Membran | unter Öffnung | 2-2,3 | 7-23 | an Fachdecke
17 | Schaumstoffstopfen | 2-33 | 2-7,2 | 24-26 | Fach hinten offen
18 | Akku im Fach | 2,5-32,5 | 9,2-46,2 | 20,9-25,6 | Fach 5,3, Wand 19,6-20,6
19 | Rückdeckel | 0-35 | 0-51 | 26-28 | Nut/Feder, TPU

Annahmen, die vor dem Druck zu prüfen sind:

- Fensterlage: Pins des Displays liegen rechts. Liegen sie links, Fenster und Scheibentasche zur Mitte spiegeln (Sichtbereich 4,55 von der Pinkante).
- XIAO: Höhe ca. 4 geschätzt, Lage der USB-C-Öffnung nach Messung anpassen.
- Verstärker: Höhe ca. 3,1 ohne Schraubklemme, liegt quer vor der Halteplatte.
- Taster: Körper Ø8 liegen zwischen Halteplatte und Akkufach (z 11,5 bis 19,5), XIAO deshalb nach rechts gerückt.
- Lautsprecherkammer: Rückraum ca. 1 cm3, Druckausgleich über kleines Loch mit Membran im Deckel.
- Akku: gemessen 4,7 dick, Fach 5,3 konstruiert. Anschlag am unteren Ende, oben bleibt Platz für das DPS310-Fach.
