MKVario/sweef/hardware/platine_v5/sweef_platine_v5.brd

## EAGLE design hardware/platine_v5/sweef_platine_v5.brd (2026-11-12)

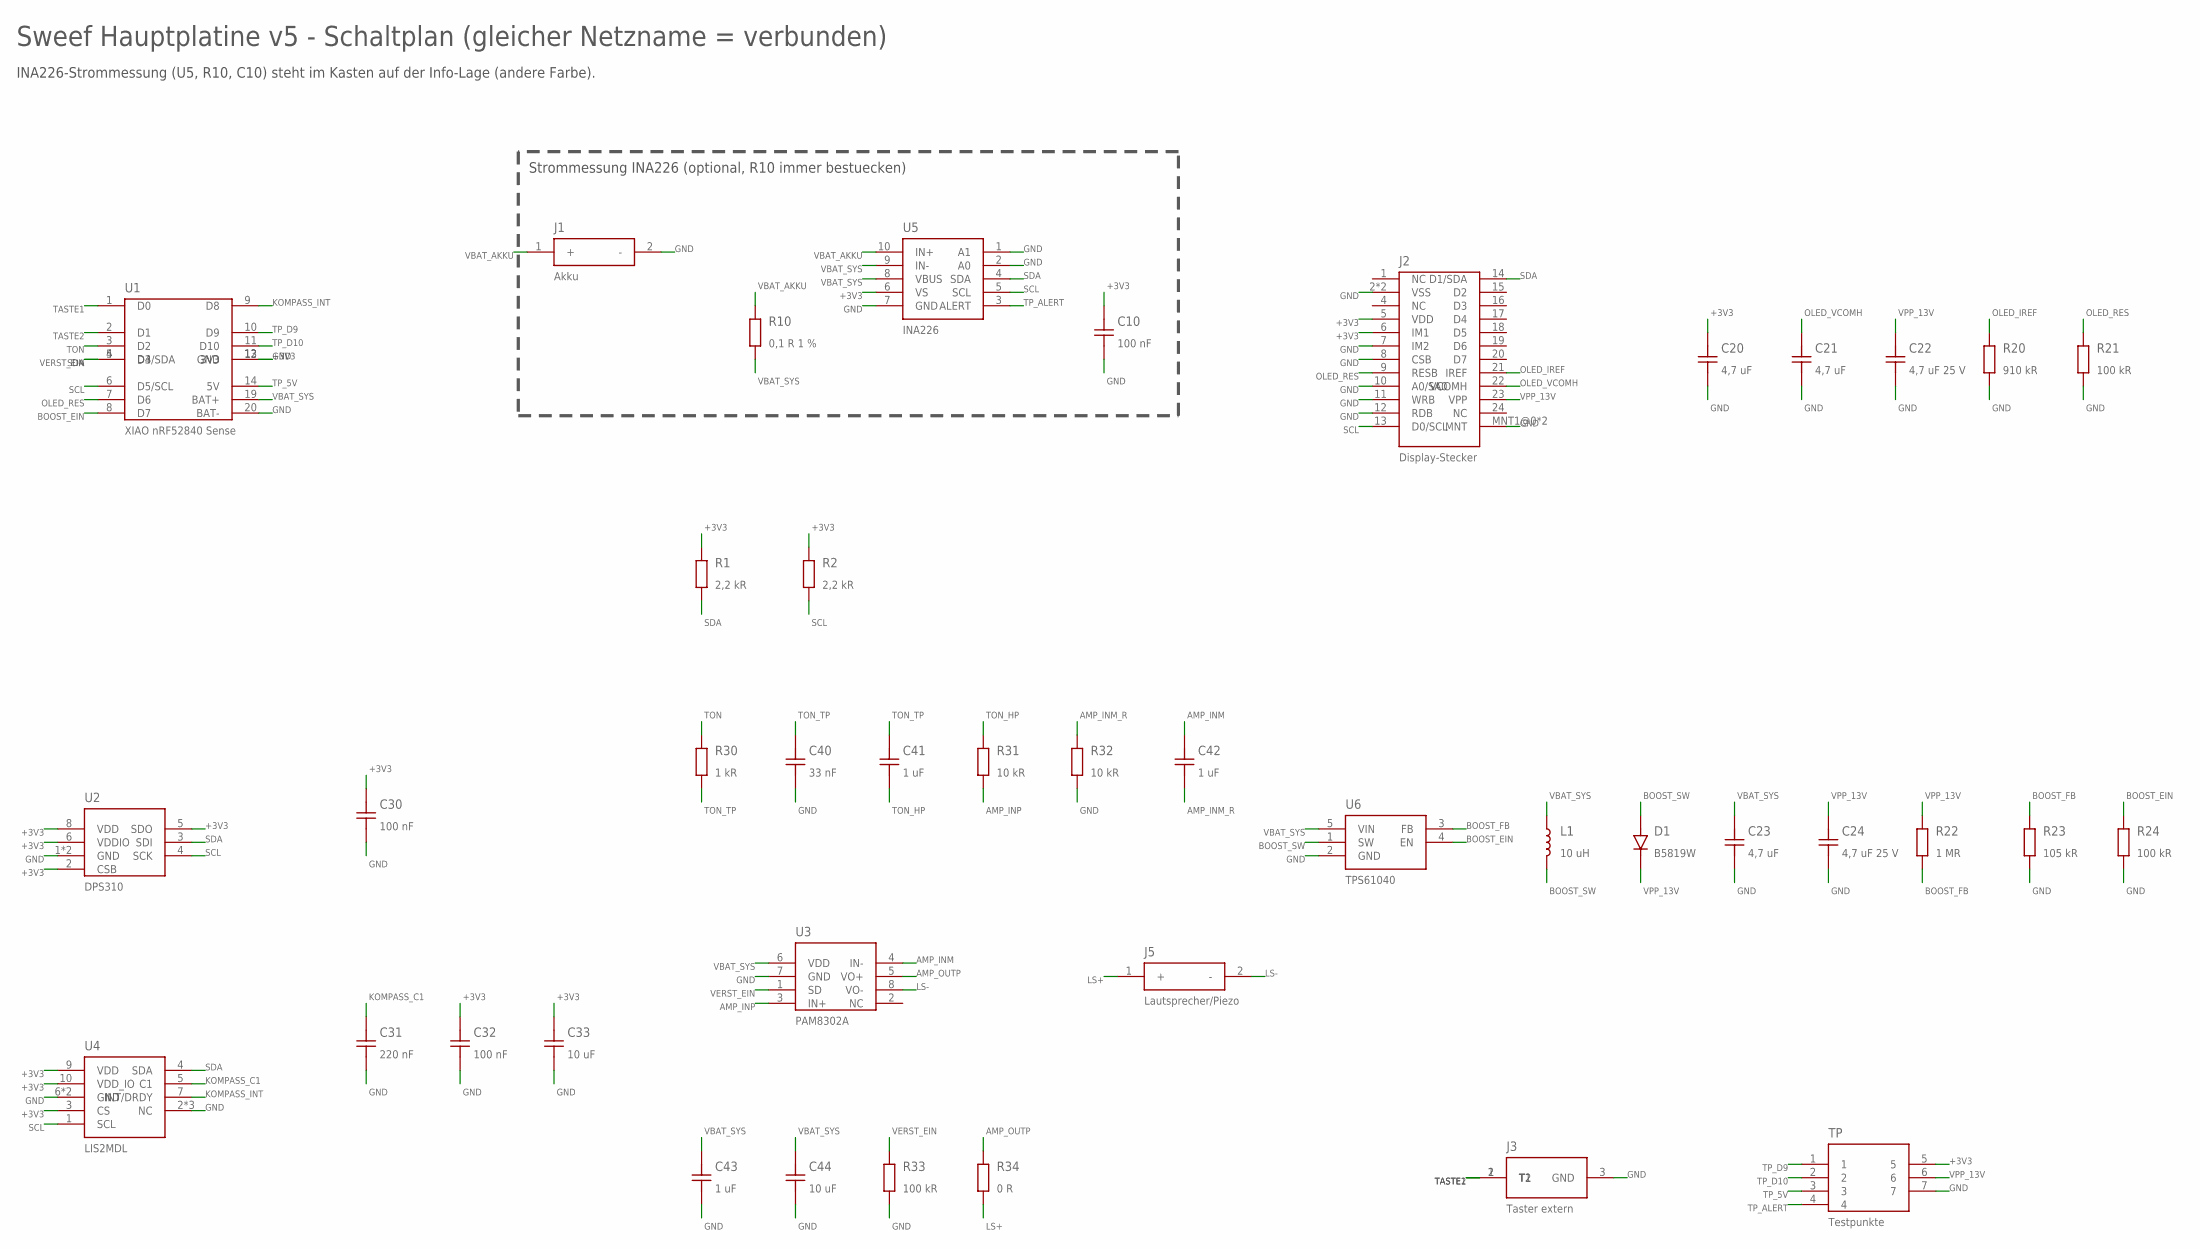
[picture p23: schematic sweef_platine_v5.sch]

Parts:
C10, C30, C32: 100 nF; C0402
C20, C21, C23: 4,7 uF; 0603-NO
C22, C24: 4,7 uF 25 V; 0805-NO
C31: 220 nF; C0402
C33, C44: 10 uF; 0603-NO
C40: 33 nF; C0402
C41, C42, C43: 1 uF; C0402
D1: B5819W; SOD-123
J1: Akku; PADS_2_AKKU
J2: Display-Stecker; FPC-24_XUNPU_FPC-05FB-24PH20
J3: Taster extern; PADS_3_TASTER
J5: Lautsprecher/Piezo; PADS_2_LS
L1: 10 uH; INDUCTOR_3X3
R1, R2: 2,2 kR; R0402
R10: 0,1 R 1 %; 0805-NO
R20: 910 kR; R0402
R21, R24, R33: 100 kR; R0402
R22: 1 MR; R0402
R23: 105 kR; R0402
R30: 1 kR; R0402
R31, R32: 10 kR; R0402
R34: 0 R; 0603-NO
TP: Testpunkte; TP_7
U1: XIAO nRF52840 Sense; XIAO_NRF52840_SMD
U2: DPS310; BMX280_COMBO
U3: PAM8302A; MSOP8_0.65MM
U4: LIS2MDL; LGA12_2X2MM
U5: INA226; MSOP10
U6: TPS61040; SOT23-5

Connections:
+3V3: C10.1, C20.1, C30.1, C32.1, C33.1, J2.5 (VDD), J2.6 (IM1), R1.1, R2.1, TP.5, U1.12 (3V3), U2.2 (CSB), U2.5 (SDO), U2.6 (VDDIO), U2.8 (VDD), U4.3 (CS), U4.9 (VDD), U4.10 (VDD_IO), U5.6 (VS)
AMP_INM: C42.1, U3.4 (IN-)
AMP_INM_R: C42.2, R32.1
AMP_INP: R31.2, U3.3 (IN+)
AMP_OUTP: R34.1, U3.5 (VO+)
BOOST_EIN: R24.1, U1.8 (D7), U6.4 (EN)
BOOST_FB: R22.2, R23.1, U6.3 (FB)
BOOST_SW: D1.A (1), L1.P$2 (2), U6.1 (SW)
GND: C10.2, C20.2, C21.2, C22.2, C23.2, C24.2, C30.2, C31.2, C32.2, C33.2, C40.2, C43.2, C44.2, J1.2 (-), J2.2 (VSS), J2.3 (VSS), J2.7 (IM2), J2.8 (CSB), J2.10 (A0/SA0), J2.11 (WRB), J2.12 (RDB), J2.MNT1@0 (MNT), J2.MNT2@0 (MNT), J3.3 (GND), R20.2, R21.2, R23.2, R24.2, R32.2, R33.2, TP.7, U1.13 (GND), U1.20 (BAT-), U2.1 (GND), U2.7 (GND), U3.7 (GND), U4.2 (NC), U4.6 (GND), U4.8 (GND), U4.11 (NC), U4.12 (NC), U5.1 (A1), U5.2 (A0), U5.7 (GND), U6.2 (GND)
KOMPASS_C1: C31.1, U4.5 (C1)
KOMPASS_INT: U1.9 (D8), U4.7 (INT/DRDY)
LS+: J5.1 (+), R34.2
LS-: J5.2 (-), U3.8 (VO-)
OLED_IREF: J2.21 (IREF), R20.1
OLED_RES: J2.9 (RESB), R21.1, U1.7 (D6)
OLED_VCOMH: C21.1, J2.22 (VCOMH)
SCL: J2.13 (D0/SCL), R2.2, U1.6 (D5/SCL), U2.4 (SCK), U4.1 (SCL), U5.5 (SCL)
SDA: J2.14 (D1/SDA), R1.2, U1.5 (D4/SDA), U2.3 (SDI), U4.4 (SDA), U5.4 (SDA)
TASTE1: J3.1 (T1), U1.1 (D0)
TASTE2: J3.2 (T2), U1.2 (D1)
TON: R30.1, U1.3 (D2)
TON_HP: C41.2, R31.1
TON_TP: C40.1, C41.1, R30.2
TP_5V: TP.3, U1.14 (5V)
TP_ALERT: TP.4, U5.3 (ALERT)
TP_D9: TP.1, U1.10 (D9)
TP_D10: TP.2, U1.11 (D10)
VBAT_AKKU: J1.1 (+), R10.1, U5.10 (IN+)
VBAT_SYS: C23.1, C43.1, C44.1, L1.P$1 (1), R10.2, U1.19 (BAT+), U3.6 (VDD), U5.8 (VBUS), U5.9 (IN-), U6.5 (VIN)
VERST_EIN: R33.1, U1.4 (D3), U3.1 (SD)
VPP_13V: C22.1, C24.1, D1.C (2), J2.23 (VPP), R22.1, TP.6

Notes on the sheet:
Sweef Hauptplatine v5 - Schaltplan (gleicher Netzname = verbunden)
INA226-Strommessung (U5, R10, C10) steht im Kasten auf der Info-Lage (andere Farbe).
Strommessung INA226 (optional, R10 immer bestuecken)

Board: 2 copper layers, 41 parts (36 on the bottom side), 31 nets, no tracks yet.
