MKVario/sweef/(commit log)

2026-10-18 App: Update mit MTU 23 und kleinen Paketgruppen (Adafruit-Bootloader), haengendes Update fortsetzen
    Claude-Session: https://claude.ai/code/session_014DnxVPVGrUZgnndjdG7uL2
2026-10-18 App: sucht selbst nach neuen App- und Firmware-Versionen und bietet die Installation an
    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
2026-10-18 Firmware 2.10.20 + App: Aktualisierungsrate der Live-Werte am Handy einstellbar
    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
2026-10-18 Firmware 2.10.22: Steigwert-Zahl am Display gemittelt und einstellbar (za)
    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
2026-10-18 App: sucht auch beim Zurueckkehren in den Vordergrund und beim Update-Knopf nach neuer App
    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
2026-10-19 App: neues Design 'Abendsonne Wilderness' – Navigation unten, Live-Karte, Info-Knoepfe, Tester-Gruppe, helle Farben als Schalter
    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
2026-10-19 App: Flugweg per Handy-GPS aufzeichnen, Karte im Flug, Export als KML (Google Earth) und IGC
    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
2026-10-19 App: 'Wo ist mein Vario?' – merkt sich den Ort beim Verbindungsabriss, Karte, Entfernung, Hinfuehren per Google Maps
    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
2026-10-19 App: Liste der geladenen Startplaetze (Suche, Entfernung, Windrichtungen, Karte, Speichern)
    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
2026-10-19 Firmware 2.10.24 + App: Startrichtung (Windrose) bei Startplaetzen, bearbeitbar, in der Frage am Vario
    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
2026-10-19 Firmware 2.10.26: Stromsparen – Prozessor schlaeft zwischen Messwerten, Display am Boden 10 Bilder/s und optional aus (ds), Bluetooth-Takt 60 ms (15 ms beim Flug-Laden), Live-Werte im Hintergrund all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
2026-10-21 Firmware 2.10.29: Flugspeicher nach Neustart aus dem Lademodus zuverlaessig erkennen (QSPI vor Neustart und bei jedem Versuch ganz abschalten)
    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
2026-10-21 Firmware 2.10.30: Neustart mit beiden Tasten prueft alle Teile neu und zeigt den Selbsttest
    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
2026-10-21 Firmware 2.10.32: Flugspeicher-Diagnose im Selbsttest (QSPI-Schritte, Kennung per Hand gelesen) und Rettung per Hand-Reset
    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
    [sweef_vario.ino]
2026-10-21 App-Version zaehlt nur noch Aenderungen an der App (keine neue App bei reinen Firmware-Updates)
    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
2026-10-21 Firmware 2.10.34: Unterstuetzung fuer Platine v5 (Erkennung am INA226, 13-V-Wandler D7, Display-Reset D6, Displayglas-Einstellungen laut Datenblatt)
    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
    [sweef_vario.ino]
2026-10-23 Firmware 2.10.35 + App: Akkutabelle 500 mAh (gemessen), Ladeanzeige nach Zeit, Einstellung Akkugroesse; Akku-Protokoll rechnet Verbrauch ab dem Abziehen
    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
2026-10-23 Firmware 2.10.36 + App: Belastungstest (volle Helligkeit, laut, Steigen 0,2-5 m/s auf und ab)
    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
2026-10-23 Firmware 2.10.37 + App: Grund der letzten Bluetooth-Trennung anzeigen; Web-App verbindet waehrend Akku-Aufzeichnung dauerhaft neu
    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
2026-10-26 Firmware 2.10.38 + App: Aufpasser startet die Bluetooth-Sichtbarkeit neu, falls sie ohne Verbindung nicht laeuft; Anzeige in der App
    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
2026-11-06 Firmware 2.10.39: INA226 und Display-Reset im Tiefschlaf aus (weniger Ruhestrom), Selbsttest zeigt auf der Platine Kompass und Strom
    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
    [sweef_vario.ino]
2026-11-06 Firmware 2.10.40 + App: Strommessung mit dem INA226 (1x pro Sekunde, Einzelmessung), Strom und Verbrauch in der App per Schalter, CSV mit Strom-Spalten
    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
2026-11-08 Firmware 2.10.41 + App: Test-Einstellung Display-Takt (Takt, Vorladung, VCOMH des Displayglases) zum Strom-Sparen
    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
2026-11-12 Projektgedächtnis für Claude Code (CLAUDE.md), Hardware v5, Messdaten und Test-Sketches ins Repo
    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
    [2026-10-19_testbrett_entladen.csv, 2026-10-21_testbrett_1.csv, 2026-10-21_testbrett_2.csv, 2026-11-06_v5_ladekurve_500mAh.csv, 2026-11-07_v5_laden_und_entladen_500mAh.csv, Vario_Stueckliste.xlsx, sweef_platine_umriss_v5.dxf, sweef_platine_v5.brd]
2026-11-12 STEP-Modell der bestückten Platine v5 für die Gehäusekonstruktion (+ Erzeugungsskript)
    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
    [sweef_platine_v5_bestueckt.step]
